StickOnAStick/48VRelay_essential/README.md

Ignore me trying to work with ki-cads git management. Project is located at `RelatBoard/48VRelay/48VERelay`
