StickOnAStick/48VRelay_essential/RelatBoard/48VRelay/48VERelay/_restore_backup_2026-08-07T21-41-39-209/report.txt

Update symbol C9 from 'Device:C_Small' to 'Device:C_Small': OK
