StickOnAStick/48VRelay_essential/RelatBoard/48VRelay/48VERelay/_restore_backup_2026-08-07T21-41-39-209/BOM/48VRelay_Approved_Vendor_List.xlsx

Sheet: Overview
48V Relay PCBA — Approved Vendor List
Generated | 2026-07-22
BOM lines | 51
Candidate rows | 204
Candidates per BOM line | 4
Primary selections | 51
Alternatives | 153
Use
This AVL is the controlled substitution list. The manufacturing BOM contains only one primary part per line. A substitute should only be used when its Approval Category is acceptable and its package, electrical limits, polarity, pinout, temperature range, and assembly method have been checked against the exact reference designators. Stock and pricing are order-time variables.
Approval category | Meaning
Primary Approved | Selected production primary for a READY line.
Approved Alternate | Intended as a drop-in alternate.
Conditional Alternate | Requires a stated electrical, mechanical, firmware, or sourcing check.
Redesign Only | Not a drop-in; layout or circuit changes are required.

Sheet: Approved Vendor List
BOM Line | Designator | BOM Value | Footprint | Candidate Rank | Role | Approval Category | Manufacturer | MPN | LCSC/JLCPCB Code | Package | Key Specifications | Availability | Price Indication | Compatibility | Qualification Notes | Source URL
1 | C1,C8,C26,C27 | 10uF | Capacitor_SMD:C_0805_2012Metric | 1 | Primary | Primary Approved | Samsung Electro-Mechanics | CL21A106KOQNNNE | C1713 | 0805 | 10 µF, 16 V, X5R, ±10% | Very high / JLC commodity |  | Drop-in |  | https://jlcpcb.com/partdetail/CL21A106KOQNNNE/C1713
1 | C1,C8,C26,C27 | 10uF | Capacitor_SMD:C_0805_2012Metric | 2 | Alternative 1 | Approved Alternate | Murata | GRM21BR61C106KE15L | C77075 | 0805 | 10 µF, 16 V, X5R, ±10% | High |  | Drop-in |  | https://jlcpcb.com/partdetail/MurataElectronics-GRM21BR61C106KE15L/C77075
1 | C1,C8,C26,C27 | 10uF | Capacitor_SMD:C_0805_2012Metric | 3 | Alternative 2 | Approved Alternate | TDK | C2012X5R1C106K125AC |  | 0805 | 10 µF, 16 V, X5R, ±10% | High / distributor commodity |  | Drop-in |  | https://www.digikey.com/en/products/result?keywords=C2012X5R1C106K125AC
1 | C1,C8,C26,C27 | 10uF | Capacitor_SMD:C_0805_2012Metric | 4 | Alternative 3 | Approved Alternate | Taiyo Yuden | EMK212BBJ106KG-T |  | 0805 | 10 µF, 16 V, X5R, ±10% | High / distributor commodity |  | Drop-in |  | https://www.digikey.com/en/products/result?keywords=EMK212BBJ106KG-T
2 | C2,C28,C29 | 10uF | Capacitor_SMD:C_0603_1608Metric | 1 | Primary | Primary - Verify | Murata | GRM188R61C106KAALD | C86275 | 0603 | 10 µF, 16 V, X5R, ±10% | High JLC stock; extended part |  | Drop-in |  | https://jlcpcb.com/partdetail/MurataElectronics-GRM188R61C106KAALD/C86275
2 | C2,C28,C29 | 10uF | Capacitor_SMD:C_0603_1608Metric | 2 | Alternative 1 | Approved Alternate | Samsung Electro-Mechanics | CL10A106KO8NQNC | C962136 | 0603 | 10 µF, 16 V, X5R, ±10% | JLC listed |  | Drop-in |  | https://www.lcsc.com/product-detail/C962136.html
2 | C2,C28,C29 | 10uF | Capacitor_SMD:C_0603_1608Metric | 3 | Alternative 2 | Conditional Alternate | Murata | GRM188R61C106MA73D | C86277 | 0603 | 10 µF, 16 V, X5R, ±20% | High JLC stock; lower cost |  | Drop-in | Tolerance is ±20%; approve only where ±20% is acceptable. | https://jlcpcb.com/partdetail/MurataElectronics-GRM188R61C106MA73D/C86277
2 | C2,C28,C29 | 10uF | Capacitor_SMD:C_0603_1608Metric | 4 | Alternative 3 | Conditional Alternate | TDK | C1608X5R1C106M080AB | C2167896 | 0603 | 10 µF, 16 V, X5R, ±20% | LCSC/JLC listed |  | Drop-in | Tolerance is ±20%; approve only where ±20% is acceptable. | https://www.lcsc.com/product-detail/C2167896.html
3 | C3,C4 | 0.1uF | Capacitor_SMD:C_0603_1608Metric | 1 | Primary | Primary Approved | Yageo | CC0603KRX7R9BB104 | C14663 | 0603 | 100 nF, 50 V, X7R, ±10% | Very high / JLC basic |  | Drop-in |  | https://jlcpcb.com/partdetail/CC0603KRX7R9BB104/C14663
3 | C3,C4 | 0.1uF | Capacitor_SMD:C_0603_1608Metric | 2 | Alternative 1 | Approved Alternate | Samsung Electro-Mechanics | CL10B104KB8NNNC |  | 0603 | 100 nF, 50 V, X7R, ±10% | High / commodity |  | Drop-in |  | https://www.digikey.com/en/products/result?keywords=CL10B104KB8NNNC
3 | C3,C4 | 0.1uF | Capacitor_SMD:C_0603_1608Metric | 3 | Alternative 2 | Approved Alternate | Murata | GRM188R71H104KA93D |  | 0603 | 100 nF, 50 V, X7R, ±10% | High / commodity |  | Drop-in |  | https://www.digikey.com/en/products/result?keywords=GRM188R71H104KA93D
3 | C3,C4 | 0.1uF | Capacitor_SMD:C_0603_1608Metric | 4 | Alternative 3 | Approved Alternate | TDK | C1608X7R1H104K080AA |  | 0603 | 100 nF, 50 V, X7R, ±10% | High / commodity |  | Drop-in |  | https://www.digikey.com/en/products/result?keywords=C1608X7R1H104K080AA
4 | C5 | 4.7uF - Eth Reference Cap | Capacitor_SMD:C_0201_0603Metric | 1 | Primary | Primary - Verify | Murata | GRM033R60J475ME05D |  | 0201 | 4.7 µF, 6.3 V, X5R, ±20% | Available, specialty/high-capacitance 0201 |  | Drop-in | Check effective capacitance under DC bias; 0201 assembly is less forgiving. | https://www.digikey.com/en/products/detail/murata-electronics/GRM033R60J475ME05D/16033659
4 | C5 | 4.7uF - Eth Reference Cap | Capacitor_SMD:C_0201_0603Metric | 2 | Alternative 1 | Approved Alternate | Samsung Electro-Mechanics | CL03A475MQ3CSNC |  | 0201 | 4.7 µF, 6.3 V, X5R, ±20% | Specialty |  | Drop-in |  | https://www.digikey.com/en/products/result?keywords=CL03A475MQ3CSNC
4 | C5 | 4.7uF - Eth Reference Cap | Capacitor_SMD:C_0201_0603Metric | 3 | Alternative 2 | Approved Alternate | TDK | C0603X5R0J475M030BC |  | 0201 | 4.7 µF, 6.3 V, X5R, ±20% | Specialty |  | Drop-in |  | https://www.digikey.com/en/products/result?keywords=C0603X5R0J475M030BC
4 | C5 | 4.7uF - Eth Reference Cap | Capacitor_SMD:C_0201_0603Metric | 4 | Alternative 3 | Approved Alternate | Taiyo Yuden | JMK063BJ475MP-F |  | 0201 | 4.7 µF, 6.3 V, X5R, ±20% | Specialty |  | Drop-in |  | https://www.digikey.com/en/products/result?keywords=JMK063BJ475MP-F
5 | C6 | 22nF | Capacitor_SMD:C_0201_0603Metric | 1 | Primary | Primary Approved | Murata | GRM033R71H223KA12D |  | 0201 | 22 nF, 50 V, X7R, ±10% | High / commodity |  | Drop-in |  | https://www.digikey.com/en/products/result?keywords=GRM033R71H223KA12D
5 | C6 | 22nF | Capacitor_SMD:C_0201_0603Metric | 2 | Alternative 1 | Approved Alternate | TDK | C0603X7R1H223K030BA |  | 0201 | 22 nF, 50 V, X7R, ±10% | High / commodity |  | Drop-in |  | https://www.digikey.com/en/products/result?keywords=C0603X7R1H223K030BA
5 | C6 | 22nF | Capacitor_SMD:C_0201_0603Metric | 3 | Alternative 2 | Approved Alternate | Samsung Electro-Mechanics | CL03B223KB3NNNC |  | 0201 | 22 nF, 50 V, X7R, ±10% | High / commodity |  | Drop-in |  | https://www.digikey.com/en/products/result?keywords=CL03B223KB3NNNC
5 | C6 | 22nF | Capacitor_SMD:C_0201_0603Metric | 4 | Alternative 3 | Approved Alternate | Yageo | CC0201KRX7R9BB223 |  | 0201 | 22 nF, 50 V, X7R, ±10% | High / commodity |  | Drop-in |  | https://www.digikey.com/en/products/result?keywords=CC0201KRX7R9BB223
6 | C7 | 0.1uF | Capacitor_SMD:C_0201_0603Metric | 1 | Primary | Primary Approved | Samsung Electro-Mechanics | CL03A104KA3NNNC | C307379 | 0201 | 100 nF, 25 V, X5R, ±10% | JLC stock; Standard PCBA only |  | Drop-in |  | https://jlcpcb.com/partdetail/291053-CL03A104KA3NNNC/C307379
6 | C7 | 0.1uF | Capacitor_SMD:C_0201_0603Metric | 2 | Alternative 1 | Approved Alternate | Murata | GRM033R71E104KE14D |  | 0201 | 100 nF, 25 V, X7R, ±10% | High / commodity |  | Drop-in |  | https://www.digikey.com/en/products/result?keywords=GRM033R71E104KE14D
6 | C7 | 0.1uF | Capacitor_SMD:C_0201_0603Metric | 3 | Alternative 2 | Approved Alternate | TDK | C0603X7R1E104K030BB |  | 0201 | 100 nF, 25 V, X7R, ±10% | High / commodity |  | Drop-in |  | https://www.digikey.com/en/products/result?keywords=C0603X7R1E104K030BB
6 | C7 | 0.1uF | Capacitor_SMD:C_0201_0603Metric | 4 | Alternative 3 | Approved Alternate | Yageo | CC0201KRX7R8BB104 |  | 0201 | 100 nF, 25 V, X7R, ±10% | High / commodity |  | Drop-in |  | https://www.digikey.com/en/products/result?keywords=CC0201KRX7R8BB104
7 | C9 | 100uF - Electrolytic | Capacitor_SMD:C_Elec_6.3x7.7 | 1 | Primary | Primary - Verify | Panasonic | EEE-FK1E101P |  | 6.3 x 7.7 mm SMD can | 100 µF, 25 V, low-ESR aluminum electrolytic | High |  | Mechanical match; verify land pattern |  | https://www.digikey.com/en/products/result?keywords=EEE-FK1E101P
7 | C9 | 100uF - Electrolytic | Capacitor_SMD:C_Elec_6.3x7.7 | 2 | Alternative 1 | Conditional Alternate | Nichicon | UWT1E101MCL1GS |  | 6.3 x 7.7 mm SMD can | 100 µF, 25 V aluminum electrolytic | High |  | Mechanical match; verify land pattern |  | https://www.digikey.com/en/products/result?keywords=UWT1E101MCL1GS
7 | C9 | 100uF - Electrolytic | Capacitor_SMD:C_Elec_6.3x7.7 | 3 | Alternative 2 | Conditional Alternate | United Chemi-Con | EMVE250ADA101MF80G |  | 6.3 x 7.7 mm SMD can | 100 µF, 25 V aluminum electrolytic | High |  | Mechanical match; verify land pattern |  | https://www.digikey.com/en/products/result?keywords=EMVE250ADA101MF80G
7 | C9 | 100uF - Electrolytic | Capacitor_SMD:C_Elec_6.3x7.7 | 4 | Alternative 3 | Conditional Alternate | Rubycon | 25SEV100M6.3X8 |  | 6.3 x 7.7/8 mm SMD can | 100 µF, 25 V aluminum electrolytic | Medium |  | Verify land pattern and height |  | https://www.digikey.com/en/products/result?keywords=25SEV100M6.3X8
8 | C10 | 100nF - Ceramic | Capacitor_SMD:C_0603_1608Metric | 1 | Primary | Primary Approved | Yageo | CC0603KRX7R9BB104 | C14663 | 0603 | 100 nF, 50 V, X7R, ±10% | Very high / JLC basic |  | Drop-in |  | https://jlcpcb.com/partdetail/CC0603KRX7R9BB104/C14663
8 | C10 | 100nF - Ceramic | Capacitor_SMD:C_0603_1608Metric | 2 | Alternative 1 | Approved Alternate | Murata | GRM188R71H104KA93D |  | 0603 | 100 nF, 50 V, X7R, ±10% | High / commodity |  | Drop-in |  | https://www.digikey.com/en/products/result?keywords=GRM188R71H104KA93D
8 | C10 | 100nF - Ceramic | Capacitor_SMD:C_0603_1608Metric | 3 | Alternative 2 | Approved Alternate | TDK | C1608X7R1H104K080AA |  | 0603 | 100 nF, 50 V, X7R, ±10% | High / commodity |  | Drop-in |  | https://www.digikey.com/en/products/result?keywords=C1608X7R1H104K080AA
8 | C10 | 100nF - Ceramic | Capacitor_SMD:C_0603_1608Metric | 4 | Alternative 3 | Approved Alternate | Samsung Electro-Mechanics | CL10B104KB8NNNC |  | 0603 | 100 nF, 50 V, X7R, ±10% | High / commodity |  | Drop-in |  | https://www.digikey.com/en/products/result?keywords=CL10B104KB8NNNC
9 | C11,C12,C13,C14,C15,C16 | 0.1uF | Capacitor_SMD:C_0402_1005Metric | 1 | Primary | Primary Approved | Samsung Electro-Mechanics | CL05B104KO5NNNC | C1525 | 0402 | 100 nF, 16 V, X7R, ±10% | Very high / JLC basic |  | Drop-in |  | https://jlcpcb.com/parts/basic_parts/
9 | C11,C12,C13,C14,C15,C16 | 0.1uF | Capacitor_SMD:C_0402_1005Metric | 2 | Alternative 1 | Approved Alternate | Murata | GRM155R71H104KE14D | C77020 | 0402 | 100 nF, 50 V, X7R, ±10% | JLC listed; extended |  | Drop-in |  | https://jlcpcb.com/partdetail/MurataElectronics-GRM155R71H104KE14D/C77020
9 | C11,C12,C13,C14,C15,C16 | 0.1uF | Capacitor_SMD:C_0402_1005Metric | 3 | Alternative 2 | Approved Alternate | Yageo | CC0402KRX7R9BB104 |  | 0402 | 100 nF, 50 V, X7R, ±10% | High / commodity |  | Drop-in |  | https://www.digikey.com/en/products/result?keywords=CC0402KRX7R9BB104
9 | C11,C12,C13,C14,C15,C16 | 0.1uF | Capacitor_SMD:C_0402_1005Metric | 4 | Alternative 3 | Approved Alternate | TDK | C1005X7R1H104K050BB |  | 0402 | 100 nF, 50 V, X7R, ±10% | High / commodity |  | Drop-in |  | https://www.digikey.com/en/products/result?keywords=C1005X7R1H104K050BB
10 | C17,C19 | 6.8nF | Capacitor_SMD:C_0201_0603Metric | 1 | Primary | Primary Approved | Murata | GRM033R71H682KA12D |  | 0201 | 6.8 nF, 50 V, X7R, ±10% | High / commodity |  | Drop-in |  | https://www.digikey.com/en/products/result?keywords=GRM033R71H682KA12D
10 | C17,C19 | 6.8nF | Capacitor_SMD:C_0201_0603Metric | 2 | Alternative 1 | Approved Alternate | TDK | C0603X7R1H682K030BA |  | 0201 | 6.8 nF, 50 V, X7R, ±10% | High / commodity |  | Drop-in |  | https://www.digikey.com/en/products/result?keywords=C0603X7R1H682K030BA
10 | C17,C19 | 6.8nF | Capacitor_SMD:C_0201_0603Metric | 3 | Alternative 2 | Approved Alternate | Samsung Electro-Mechanics | CL03B682KB3NNNC |  | 0201 | 6.8 nF, 50 V, X7R, ±10% | High / commodity |  | Drop-in |  | https://www.digikey.com/en/products/result?keywords=CL03B682KB3NNNC
10 | C17,C19 | 6.8nF | Capacitor_SMD:C_0201_0603Metric | 4 | Alternative 3 | Approved Alternate | Yageo | CC0201KRX7R9BB682 |  | 0201 | 6.8 nF, 50 V, X7R, ±10% | High / commodity |  | Drop-in |  | https://www.digikey.com/en/products/result?keywords=CC0201KRX7R9BB682
11 | C18 | 10uF / 16V | Capacitor_SMD:C_0805_2012Metric | 1 | Primary | Primary Approved | Samsung Electro-Mechanics | CL21A106KOQNNNE |  | 0805 | 10 µF, 16 V, X5R, ±10% | Medium; exact Samsung listing varies |  | Drop-in |  | https://www.digikey.com/en/products/detail/samsung-electro-mechanics/CL21A106KOQNNNE/3886754
11 | C18 | 10uF / 16V | Capacitor_SMD:C_0805_2012Metric | 2 | Alternative 1 | Approved Alternate | Murata | GRM21BR61C106KE15L |  | 0805 | 10 µF, 16 V, X5R, ±10% | High / commodity |  | Drop-in |  | https://www.digikey.com/en/products/result?keywords=GRM21BR61C106KE15L
11 | C18 | 10uF / 16V | Capacitor_SMD:C_0805_2012Metric | 3 | Alternative 2 | Approved Alternate | TDK | C2012X5R1C106K125AC |  | 0805 | 10 µF, 16 V, X5R, ±10% | High / commodity |  | Drop-in |  | https://www.digikey.com/en/products/result?keywords=C2012X5R1C106K125AC
11 | C18 | 10uF / 16V | Capacitor_SMD:C_0805_2012Metric | 4 | Alternative 3 | Approved Alternate | Taiyo Yuden | EMK212BBJ106KG-T |  | 0805 | 10 µF, 16 V, X5R, ±10% | High / commodity |  | Drop-in |  | https://www.digikey.com/en/products/result?keywords=EMK212BBJ106KG-T
12 | C20,C23 | 10nF | Capacitor_SMD:C_0201_0603Metric | 1 | Primary | Primary Approved | Murata | GRM033R71H103KA12D |  | 0201 | 10 nF, 50 V, X7R, ±10% | High / commodity |  | Drop-in |  | https://www.digikey.com/en/products/result?keywords=GRM033R71H103KA12D
12 | C20,C23 | 10nF | Capacitor_SMD:C_0201_0603Metric | 2 | Alternative 1 | Approved Alternate | TDK | C0603X7R1H103K030BB |  | 0201 | 10 nF, 50 V, X7R, ±10% | High / commodity |  | Drop-in |  | https://www.digikey.com/en/products/result?keywords=C0603X7R1H103K030BB
12 | C20,C23 | 10nF | Capacitor_SMD:C_0201_0603Metric | 3 | Alternative 2 | Approved Alternate | Samsung Electro-Mechanics | CL03B103KB3NNNC |  | 0201 | 10 nF, 50 V, X7R, ±10% | High / commodity |  | Drop-in |  | https://www.digikey.com/en/products/result?keywords=CL03B103KB3NNNC
12 | C20,C23 | 10nF | Capacitor_SMD:C_0201_0603Metric | 4 | Alternative 3 | Approved Alternate | Yageo | CC0201KRX7R9BB103 |  | 0201 | 10 nF, 50 V, X7R, ±10% | High / commodity |  | Drop-in |  | https://www.digikey.com/en/products/result?keywords=CC0201KRX7R9BB103
13 | C21,C22 | 18pF | Capacitor_SMD:C_0201_0603Metric | 1 | Primary | Primary Approved | Murata | GRM0335C1H180JA01D |  | 0201 | 18 pF, 50 V, C0G/NP0, ±5% | High / commodity |  | Drop-in |  | https://www.digikey.com/en/products/result?keywords=GRM0335C1H180JA01D
13 | C21,C22 | 18pF | Capacitor_SMD:C_0201_0603Metric | 2 | Alternative 1 | Approved Alternate | TDK | C0603C0G1H180J030BA |  | 0201 | 18 pF, 50 V, C0G/NP0, ±5% | High / commodity |  | Drop-in |  | https://www.digikey.com/en/products/result?keywords=C0603C0G1H180J030BA
13 | C21,C22 | 18pF | Capacitor_SMD:C_0201_0603Metric | 3 | Alternative 2 | Approved Alternate | Samsung Electro-Mechanics | CL03C180JB3NNNC |  | 0201 | 18 pF, 50 V, C0G/NP0, ±5% | High / commodity |  | Drop-in |  | https://www.digikey.com/en/products/result?keywords=CL03C180JB3NNNC
13 | C21,C22 | 18pF | Capacitor_SMD:C_0201_0603Metric | 4 | Alternative 3 | Approved Alternate | Yageo | CC0201JRNPO9BN180 |  | 0201 | 18 pF, 50 V, C0G/NP0, ±5% | High / commodity |  | Drop-in |  | https://www.digikey.com/en/products/result?keywords=CC0201JRNPO9BN180
14 | C24 | 1uF - Ceramic | Capacitor_SMD:C_0805_2012Metric | 1 | Primary | Primary Approved | Samsung Electro-Mechanics | CL21A105KAFNNNE | C95840 | 0805 | 1 µF, 25 V, X5R, ±10% | High / commodity |  | Drop-in |  | https://jlcpcb.com/partdetail/97044-CL21A105KAFNNNE/C95840
14 | C24 | 1uF - Ceramic | Capacitor_SMD:C_0805_2012Metric | 2 | Alternative 1 | Approved Alternate | Murata | GRM21BR71E105KA99L |  | 0805 | 1 µF, 25 V, X7R, ±10% | High / commodity |  | Drop-in |  | https://www.digikey.com/en/products/result?keywords=GRM21BR71E105KA99L
14 | C24 | 1uF - Ceramic | Capacitor_SMD:C_0805_2012Metric | 3 | Alternative 2 | Approved Alternate | TDK | C2012X7R1E105K125AB |  | 0805 | 1 µF, 25 V, X7R, ±10% | High / commodity |  | Drop-in |  | https://www.digikey.com/en/products/result?keywords=C2012X7R1E105K125AB
14 | C24 | 1uF - Ceramic | Capacitor_SMD:C_0805_2012Metric | 4 | Alternative 3 | Approved Alternate | Taiyo Yuden | TMK212B7105KG-T |  | 0805 | 1 µF, 25 V, X7R, ±10% | High / commodity |  | Drop-in |  | https://www.digikey.com/en/products/result?keywords=TMK212B7105KG-T
15 | C25 | 100nF | Capacitor_SMD:C_0201_0603Metric | 1 | Primary | Primary Approved | Samsung Electro-Mechanics | CL03A104KA3NNNC | C307379 | 0201 | 100 nF, 25 V, X5R, ±10% | JLC stock; Standard PCBA only |  | Drop-in |  | https://jlcpcb.com/partdetail/291053-CL03A104KA3NNNC/C307379
15 | C25 | 100nF | Capacitor_SMD:C_0201_0603Metric | 2 | Alternative 1 | Approved Alternate | Murata | GRM033R71E104KE14D |  | 0201 | 100 nF, 25 V, X7R, ±10% | High / commodity |  | Drop-in |  | https://www.digikey.com/en/products/result?keywords=GRM033R71E104KE14D
15 | C25 | 100nF | Capacitor_SMD:C_0201_0603Metric | 3 | Alternative 2 | Approved Alternate | TDK | C0603X7R1E104K030BB |  | 0201 | 100 nF, 25 V, X7R, ±10% | High / commodity |  | Drop-in |  | https://www.digikey.com/en/products/result?keywords=C0603X7R1E104K030BB
15 | C25 | 100nF | Capacitor_SMD:C_0201_0603Metric | 4 | Alternative 3 | Approved Alternate | Yageo | CC0201KRX7R8BB104 |  | 0201 | 100 nF, 25 V, X7R, ±10% | High / commodity |  | Drop-in |  | https://www.digikey.com/en/products/result?keywords=CC0201KRX7R8BB104
16 | C30,C31 | 22uF | Capacitor_SMD:C_0805_2012Metric | 1 | Primary | Primary - Verify | Murata | GRM21BR61A226ME44K |  | 0805 | 22 µF, 10 V, X5R, ±20% | High |  | Drop-in | Verify effective capacitance at the actual rail voltage. | https://www.digikey.com/en/products/detail/murata-electronics/GRM21BR61A226ME44K/26223516
16 | C30,C31 | 22uF | Capacitor_SMD:C_0805_2012Metric | 2 | Alternative 1 | Approved Alternate | TDK | C2012X5R1A226M125AC |  | 0805 | 22 µF, 10 V, X5R, ±20% | High / commodity |  | Drop-in |  | https://www.digikey.com/en/products/result?keywords=C2012X5R1A226M125AC
16 | C30,C31 | 22uF | Capacitor_SMD:C_0805_2012Metric | 3 | Alternative 2 | Approved Alternate | Taiyo Yuden | LMK212BBJ226MG-T |  | 0805 | 22 µF, 10 V, X5R, ±20% | High / commodity |  | Drop-in |  | https://www.digikey.com/en/products/result?keywords=LMK212BBJ226MG-T
16 | C30,C31 | 22uF | Capacitor_SMD:C_0805_2012Metric | 4 | Alternative 3 | Approved Alternate | Kyocera AVX | 0805ZD226MAT2A |  | 0805 | 22 µF, 10 V, X5R, ±20% | High / commodity |  | Drop-in |  | https://www.digikey.com/en/products/result?keywords=0805ZD226MAT2A
17 | C32,C33,C34,C35 | 1uF | Capacitor_SMD:C_0805_2012Metric | 1 | Primary | Primary Approved | Samsung Electro-Mechanics | CL21A105KAFNNNE | C95840 | 0805 | 1 µF, 25 V, X5R, ±10% | JLC listed / high |  | Drop-in |  | https://jlcpcb.com/partdetail/97044-CL21A105KAFNNNE/C95840
17 | C32,C33,C34,C35 | 1uF | Capacitor_SMD:C_0805_2012Metric | 2 | Alternative 1 | Approved Alternate | Samsung Electro-Mechanics | CL21B105KAFNNNE | C116352 | 0805 | 1 µF, 25 V, X7R, ±10% | JLC listed |  | Drop-in |  | https://jlcpcb.com/partdetail/117606-CL21B105KAFNNNE/C116352
17 | C32,C33,C34,C35 | 1uF | Capacitor_SMD:C_0805_2012Metric | 3 | Alternative 2 | Approved Alternate | Murata | GRM21BR71E105KA99L |  | 0805 | 1 µF, 25 V, X7R, ±10% | High / commodity |  | Drop-in |  | https://www.digikey.com/en/products/result?keywords=GRM21BR71E105KA99L
17 | C32,C33,C34,C35 | 1uF | Capacitor_SMD:C_0805_2012Metric | 4 | Alternative 3 | Approved Alternate | TDK | C2012X7R1E105K125AB |  | 0805 | 1 µF, 25 V, X7R, ±10% | High / commodity |  | Drop-in |  | https://www.digikey.com/en/products/result?keywords=C2012X7R1E105K125AB
18 | C36,C37 | 1uF | Capacitor_SMD:C_0402_1005Metric | 1 | Primary | Primary Approved | Samsung Electro-Mechanics | CL05A105KO5NNNC | C29266 | 0402 | 1 µF, 16 V, X5R, ±10% | JLC listed |  | Drop-in |  | https://jlcpcb.com/partdetail/C29266
18 | C36,C37 | 1uF | Capacitor_SMD:C_0402_1005Metric | 2 | Alternative 1 | Approved Alternate | Samsung Electro-Mechanics | CL05A105KA5NQNC | C52923 | 0402 | 1 µF, 25 V, X5R, ±10% | JLC listed |  | Drop-in |  | https://jlcpcb.com/partdetail/C52923
18 | C36,C37 | 1uF | Capacitor_SMD:C_0402_1005Metric | 3 | Alternative 2 | Conditional Alternate | Samsung Electro-Mechanics | CL05A105KP5NNNC | C14445 | 0402 | 1 µF, 10 V, X5R, ±10% | JLC listed / low cost |  | Drop-in | Use only on rails comfortably below 10 V. | https://jlcpcb.com/partdetail/CL05A105KP5NNNC/C14445
18 | C36,C37 | 1uF | Capacitor_SMD:C_0402_1005Metric | 4 | Alternative 3 | Conditional Alternate | Murata | GRM155R61A105KE15D |  | 0402 | 1 µF, 10 V, X5R, ±10% | High / commodity |  | Drop-in | Use only on rails comfortably below 10 V. | https://www.digikey.com/en/products/result?keywords=GRM155R61A105KE15D
19 | D1,D2,D3,D4,D5 | LED VO-PT2012SEAC | LED_SMD:LED_0201_0603Metric | 1 | Primary | Proposed / Not Released | Lite-On | LTST-FC03AD-5A | C20617265 | LED 0201 | Amber/yellow indicator LED; verify Vf and polarity | JLC listing; check order-time stock |  | Drop-in |  | https://jlcpcb.com/partdetail/LiteOn-LTST_FC03AD5A/C20617265
19 | D1,D2,D3,D4,D5 | LED VO-PT2012SEAC | LED_SMD:LED_0201_0603Metric | 2 | Alternative 1 | Approved Alternate | Lite-On | LTST-FC03ED-5A | C20617267 | LED 0201 | Red indicator LED; verify desired color | JLC listing; check order-time stock |  | Drop-in |  | https://jlcpcb.com/partdetail/LiteOn-LTST_FC03ED5A/C20617267
19 | D1,D2,D3,D4,D5 | LED VO-PT2012SEAC | LED_SMD:LED_0201_0603Metric | 3 | Alternative 2 | Approved Alternate | Lite-On | LTST-FC03BD-5A | C20617266 | LED 0201 | Blue indicator LED; verify desired color | JLC listing; check order-time stock |  | Drop-in |  | https://jlcpcb.com/partdetail/LiteOn-LTST_FC03BD5A/C20617266
19 | D1,D2,D3,D4,D5 | LED VO-PT2012SEAC | LED_SMD:LED_0201_0603Metric | 4 | Alternative 3 | Approved Alternate | Everlight | CSP0603AN101-IBP20200453001-3T |  | LED 0201 | Indicator LED; verify color/bin and polarity | JLC searchable; check order-time stock |  | Drop-in |  | https://jlcpcb.com/parts/componentSearch?searchTxt=CSP0603AN101-IBP20200453001-3T
20 | D6 | LED | LED_SMD:LED_0201_0603Metric | 1 | Primary | Primary - Verify | Lite-On | LTST-FC03ED-5A | C20617267 | LED 0201 | Red indicator LED; verify desired color | JLC listing; check order-time stock |  | Drop-in |  | https://jlcpcb.com/partdetail/LiteOn-LTST_FC03ED5A/C20617267
20 | D6 | LED | LED_SMD:LED_0201_0603Metric | 2 | Alternative 1 | Approved Alternate | Lite-On | LTST-FC03AD-5A | C20617265 | LED 0201 | Amber/yellow indicator LED; verify Vf and polarity | JLC listing; check order-time stock |  | Drop-in |  | https://jlcpcb.com/partdetail/LiteOn-LTST_FC03AD5A/C20617265
20 | D6 | LED | LED_SMD:LED_0201_0603Metric | 3 | Alternative 2 | Approved Alternate | Lite-On | LTST-FC03BD-5A | C20617266 | LED 0201 | Blue indicator LED; verify desired color | JLC listing; check order-time stock |  | Drop-in |  | https://jlcpcb.com/partdetail/LiteOn-LTST_FC03BD5A/C20617266
20 | D6 | LED | LED_SMD:LED_0201_0603Metric | 4 | Alternative 3 | Approved Alternate | Everlight | CSP0603AN101-IBP20200453001-3T |  | LED 0201 | Indicator LED; verify color/bin and polarity | JLC searchable; check order-time stock |  | Drop-in |  | https://jlcpcb.com/parts/componentSearch?searchTxt=CSP0603AN101-IBP20200453001-3T
21 | F1,F2,F5 | 0685T5000 | Fuse:Fuse_0805_2012Metric | 1 | Primary | Proposed / Not Released | Bel Fuse | 0685T5000-01 |  | 1206 | 5 A, 63 V AC/DC, time-delay fuse | Very high distributor stock; JLC order-time check | ~$0.45-$0.80 | Layout change: current BOM footprint is 0805 |  | https://www.digikey.com/en/products/detail/bel-fuse-inc/0685T5000-01/4967966
21 | F1,F2,F5 | 0685T5000 | Fuse:Fuse_0805_2012Metric | 2 | Alternative 1 | Redesign Only | Bourns | SF-1206S500-2 |  | 1206 | 5 A slow-blow chip fuse; verify voltage/time-current | High |  | Layout change: 1206 |  | https://www.digikey.com/en/products/result?keywords=SF-1206S500-2
21 | F1,F2,F5 | 0685T5000 | Fuse:Fuse_0805_2012Metric | 3 | Alternative 2 | Redesign Only | Eaton | CC12H5A-TR |  | 1206 | 5 A chip fuse; verify time-delay curve | High |  | Layout change: 1206 |  | https://www.digikey.com/en/products/result?keywords=CC12H5A-TR
21 | F1,F2,F5 | 0685T5000 | Fuse:Fuse_0805_2012Metric | 4 | Alternative 3 | Redesign Only | Littelfuse | 0467005.NRHF |  | 1206 | 5 A chip fuse; verify speed and DC interrupt rating | High |  | Layout change: 1206 |  | https://www.digikey.com/en/products/result?keywords=0467005.NRHF
22 | F3,F4 | 0685T5000-01 | Fuse:Fuse_0805_2012Metric | 1 | Primary | Proposed / Not Released | Bel Fuse | 0685T5000-01 |  | 1206 | 5 A, 63 V AC/DC, time-delay fuse | Very high distributor stock; JLC order-time check | ~$0.45-$0.80 | Layout change: current BOM footprint is 0805 |  | https://www.digikey.com/en/products/detail/bel-fuse-inc/0685T5000-01/4967966
22 | F3,F4 | 0685T5000-01 | Fuse:Fuse_0805_2012Metric | 2 | Alternative 1 | Redesign Only | Bourns | SF-1206S500-2 |  | 1206 | 5 A slow-blow chip fuse; verify voltage/time-current | High |  | Layout change: 1206 |  | https://www.digikey.com/en/products/result?keywords=SF-1206S500-2
22 | F3,F4 | 0685T5000-01 | Fuse:Fuse_0805_2012Metric | 3 | Alternative 2 | Redesign Only | Eaton | CC12H5A-TR |  | 1206 | 5 A chip fuse; verify time-delay curve | High |  | Layout change: 1206 |  | https://www.digikey.com/en/products/result?keywords=CC12H5A-TR
22 | F3,F4 | 0685T5000-01 | Fuse:Fuse_0805_2012Metric | 4 | Alternative 3 | Redesign Only | Littelfuse | 0467005.NRHF |  | 1206 | 5 A chip fuse; verify speed and DC interrupt rating | High |  | Layout change: 1206 |  | https://www.digikey.com/en/products/result?keywords=0467005.NRHF
23 | J1 | 12 | Connector_BarrelJack:BarrelJack_CUI_PJ-102AH_Horizontal | 1 | Primary | Primary - Verify | Same Sky / CUI Devices | PJ-102AH | C9900001188 | THT horizontal barrel jack | 2.0 mm center pin, switched contact; verify adapter plug/current | Available at distributors; JLC extended/preorder |  | Drop-in |  | https://jlcpcb.com/partdetail/CUIDevices-PJ102AH/C9900001188
23 | J1 | 12 | Connector_BarrelJack:BarrelJack_CUI_PJ-102AH_Horizontal | 2 | Alternative 1 | Conditional Alternate | GCT | DCJ200-10-A-K1-K |  | THT horizontal barrel jack | 2.0 mm center pin; verify pinout/current | High |  | Mechanical/pinout verification |  | https://www.digikey.com/en/products/result?keywords=DCJ200-10-A-K1-K
23 | J1 | 12 | Connector_BarrelJack:BarrelJack_CUI_PJ-102AH_Horizontal | 3 | Alternative 2 | Conditional Alternate | Kycon | KLDX-0202-A |  | THT horizontal barrel jack | 2.0 mm center pin; verify pinout/current | High |  | Layout likely changes |  | https://www.digikey.com/en/products/result?keywords=KLDX-0202-A
23 | J1 | 12 | Connector_BarrelJack:BarrelJack_CUI_PJ-102AH_Horizontal | 4 | Alternative 3 | Conditional Alternate | Same Sky / CUI Devices | PJ-102A |  | THT horizontal barrel jack | 2.0 mm center pin; verify switch/pinout | High |  | Layout/pinout verification |  | https://www.digikey.com/en/products/result?keywords=PJ-102A
24 | J2 | RJ45_Hanrun_HR911105A_Horizontal | Connector_RJ:RJ45_Hanrun_HR911105A_Horizontal | 1 | Primary | Primary Approved | HanRun | HR911105A | C12074 | THT MagJack | 10/100BASE-T, integrated magnetics and LEDs | JLC stock reported high | ~$1.49 | Drop-in |  | https://jlcpcb.com/partdetail/HanRun-HR911105A/C12074
24 | J2 | RJ45_Hanrun_HR911105A_Horizontal | Connector_RJ:RJ45_Hanrun_HR911105A_Horizontal | 2 | Alternative 1 | Conditional Alternate | UDE | RB1-125BAG1A |  | THT MagJack | 10/100BASE-T integrated magnetics/LEDs | High |  | Mechanical/pinout verification |  | https://www.digikey.com/en/products/result?keywords=RB1-125BAG1A
24 | J2 | RJ45_Hanrun_HR911105A_Horizontal | Connector_RJ:RJ45_Hanrun_HR911105A_Horizontal | 3 | Alternative 2 | Conditional Alternate | Pulse Electronics | J0011D21BNL |  | THT MagJack | 10/100BASE-T integrated magnetics/LEDs | High |  | Layout/pinout change likely |  | https://www.digikey.com/en/products/result?keywords=J0011D21BNL
24 | J2 | RJ45_Hanrun_HR911105A_Horizontal | Connector_RJ:RJ45_Hanrun_HR911105A_Horizontal | 4 | Alternative 3 | Conditional Alternate | Würth Elektronik | 7499111121A |  | THT MagJack | 10/100BASE-T integrated magnetics/LEDs | High |  | Layout/pinout change likely |  | https://www.digikey.com/en/products/result?keywords=7499111121A
25 | J3 | B4B-PH-SM4-TB | Connector_PinHeader_2.54mm:PinHeader_1x04_P2.54mm_Vertical | 1 | Primary | Proposed / Not Released | BOOMELE / generic | 2.54-1*4P | C49257 | 1x4, 2.54 mm, vertical THT | Standard male pin header | Very high / JLC commodity | <$0.05 typical | Matches current KiCad footprint; not JST-PH |  | https://www.lcsc.com/search?q=C49257
25 | J3 | B4B-PH-SM4-TB | Connector_PinHeader_2.54mm:PinHeader_1x04_P2.54mm_Vertical | 2 | Alternative 1 | Approved Alternate | Harwin | M20-9990445 |  | 1x4, 2.54 mm, vertical THT | Gold/tin pin header | High |  | Drop-in mechanical |  | https://www.digikey.com/en/products/result?keywords=M20-9990445
25 | J3 | B4B-PH-SM4-TB | Connector_PinHeader_2.54mm:PinHeader_1x04_P2.54mm_Vertical | 3 | Alternative 2 | Approved Alternate | Würth Elektronik | 61300411121 |  | 1x4, 2.54 mm, vertical THT | Standard pin header | High |  | Drop-in mechanical |  | https://www.digikey.com/en/products/result?keywords=61300411121
25 | J3 | B4B-PH-SM4-TB | Connector_PinHeader_2.54mm:PinHeader_1x04_P2.54mm_Vertical | 4 | Alternative 3 | Conditional Alternate | Samtec | TSW-104-07-G-S |  | 1x4, 2.54 mm, vertical THT | Premium pin header | High |  | Drop-in mechanical; verify pin length |  | https://www.digikey.com/en/products/result?keywords=TSW-104-07-G-S
26 | J10,J11,J12,J13,J14 | Screw_Terminal_01x03 | TerminalBlock:TerminalBlock_MaiXu_MX126-5.0-03P_1x03_P5.00mm | 1 | Primary | Primary - Verify | MAX / MaiXu | MX126-5.0-03P-GN01-Cu-S-A | C5188435 | 3-pos THT, 5.00 mm | 10 A, 300 V, 14-26 AWG | JLC listed | ~$0.10-$0.25 | Drop-in if exact custom footprint |  | https://jlcpcb.com/partdetail/MAX-MX126_5_003P_GN01_Cu_S_A/C5188435
26 | J10,J11,J12,J13,J14 | Screw_Terminal_01x03 | TerminalBlock:TerminalBlock_MaiXu_MX126-5.0-03P_1x03_P5.00mm | 2 | Alternative 1 | Conditional Alternate | Degson | DG126-5.0-03P-1400AH |  | 3-pos THT, 5.00 mm | Terminal block, 5.0 mm pitch | High |  | Verify body/pin dimensions |  | https://www.digikey.com/en/products/result?keywords=DG126-5.0-03P-1400AH
26 | J10,J11,J12,J13,J14 | Screw_Terminal_01x03 | TerminalBlock:TerminalBlock_MaiXu_MX126-5.0-03P_1x03_P5.00mm | 3 | Alternative 2 | Conditional Alternate | On Shore Technology | OSTTA034163 |  | 3-pos THT, 5.00 mm | Terminal block, 5.0 mm pitch | High |  | Verify body/pin dimensions |  | https://www.digikey.com/en/products/result?keywords=OSTTA034163
26 | J10,J11,J12,J13,J14 | Screw_Terminal_01x03 | TerminalBlock:TerminalBlock_MaiXu_MX126-5.0-03P_1x03_P5.00mm | 4 | Alternative 3 | Redesign Only | Phoenix Contact | 1935161 |  | 3-pos THT, 5.08 mm | MKDS series terminal block | High |  | Pitch/layout change: 5.08 mm |  | https://www.digikey.com/en/products/result?keywords=1935161
27 | K10,K11,K12,K13,K14 | G2RL-1-E | Relay_THT:Relay_SPDT_Omron_G2RL-1-E | 1 | Primary | Primary - Verify | Omron | G2RL-1-E-DC12 | C58243 | THT SPDT | 12 V coil; 16 A at 24 VDC resistive; 300 VDC max switching voltage | JLC stock reported high | ~$1.57 | Drop-in | 48-52 VDC at 2 A is not the published rated-load point; qualify against the DC load curve, load type, life, and certification. | https://jlcpcb.com/partdetail/Omron-G2RL_1_E_DC12/C58243
27 | K10,K11,K12,K13,K14 | G2RL-1-E | Relay_THT:Relay_SPDT_Omron_G2RL-1-E | 2 | Alternative 1 | Conditional Alternate | Omron | G2RL-1-E-ASI-DC12 |  | THT SPDT | 12 V coil, high-capacity G2RL variant | High |  | Likely footprint-compatible; verify exact suffix |  | https://www.digikey.com/en/products/result?keywords=G2RL-1-E-ASI-DC12
27 | K10,K11,K12,K13,K14 | G2RL-1-E | Relay_THT:Relay_SPDT_Omron_G2RL-1-E | 3 | Alternative 2 | Conditional Alternate | TE Connectivity / Schrack | RT314012 |  | THT SPDT | 12 V coil power relay | High |  | Layout/pinout change likely; verify DC load rating |  | https://www.digikey.com/en/products/result?keywords=RT314012
27 | K10,K11,K12,K13,K14 | G2RL-1-E | Relay_THT:Relay_SPDT_Omron_G2RL-1-E | 4 | Alternative 3 | Conditional Alternate | Hongfa | HF115F/012-1ZS3 |  | THT SPDT | 12 V coil power relay | High |  | Layout/pinout change likely; verify DC load rating |  | https://www.digikey.com/en/products/result?keywords=HF115F%2F012-1ZS3
28 | L1 | MH1608-121Y | Library:IND_BOURNS_MH1608 | 1 | Primary | Primary Approved | Bourns | MH1608-121Y | C2650949 | 0603 | 120 Ω @ 100 MHz, 2 A, ≤100 mΩ | LCSC stock reported moderate | ~$0.06 | Drop-in |  | https://www.lcsc.com/product-detail/Ferrite-Beads_Bourns-MH1608-121Y_C2650949.html
28 | L1 | MH1608-121Y | Library:IND_BOURNS_MH1608 | 2 | Alternative 1 | Approved Alternate | TDK | MPZ1608S121ATA00 |  | 0603 | 120 Ω @ 100 MHz, 2 A class | Very high |  | Drop-in |  | https://www.digikey.com/en/products/result?keywords=MPZ1608S121ATA00
28 | L1 | MH1608-121Y | Library:IND_BOURNS_MH1608 | 3 | Alternative 2 | Approved Alternate | Murata | BLM18AG121SN1D |  | 0603 | 120 Ω @ 100 MHz, 2 A class | Very high |  | Drop-in |  | https://www.digikey.com/en/products/result?keywords=BLM18AG121SN1D
28 | L1 | MH1608-121Y | Library:IND_BOURNS_MH1608 | 4 | Alternative 3 | Approved Alternate | Taiyo Yuden | BK1608HS121-T |  | 0603 | 120 Ω @ 100 MHz; verify current/DCR | High |  | Drop-in |  | https://www.digikey.com/en/products/result?keywords=BK1608HS121-T
29 | L3 | XFL4020-152MEC | Library:IND_XFL4020_COC-M | 1 | Primary | Primary Approved | Coilcraft | XGL4020-152MEC |  | 4.0 x 4.0 mm | 1.5 µH, lower DCR, high-current; official drop-in successor to XFL4020 | High distributor availability |  | Drop-in / preferred upgrade |  | https://www.coilcraft.com/en-us/products/power/shielded-inductors/molded-inductor/xgl/xgl4020/
29 | L3 | XFL4020-152MEC | Library:IND_XFL4020_COC-M | 2 | Alternative 1 | Approved Alternate | Coilcraft | XFL4020-152MEC | C3033018 | 4.0 x 4.0 mm | 1.5 µH, ~4.6 A saturation class, low DCR | JLC listed |  | Drop-in |  | https://jlcpcb.com/partdetail/Coilcraft-XFL4020_152MEC/C3033018
29 | L3 | XFL4020-152MEC | Library:IND_XFL4020_COC-M | 3 | Alternative 2 | Conditional Alternate | Coilcraft | XEL4020-152MEC |  | 4.0 x 4.0 mm | 1.5 µH, high saturation current | High |  | Footprint-compatible family; verify height/loss |  | https://www.digikey.com/en/products/result?keywords=XEL4020-152MEC
29 | L3 | XFL4020-152MEC | Library:IND_XFL4020_COC-M | 4 | Alternative 3 | Conditional Alternate | Bourns | SRP4020TA-1R5M |  | 4.0 x 4.0 mm class | 1.5 µH shielded power inductor | High |  | Verify pad pattern, DCR, Isat and Irms |  | https://www.digikey.com/en/products/result?keywords=SRP4020TA-1R5M
30 | R1,R2,R3,R4,R5 | 2.2k | Resistor_SMD:R_0603_1608Metric | 1 | Primary | Primary Approved | UniOhm/Uniohm | 0603WAF2201T5E |  | 0603 | 2.2 kΩ, 1%, ≥0.1 W | Very high / commodity | <$0.01 typical | Drop-in |  | https://www.lcsc.com/search?q=0603WAF2201T5E
30 | R1,R2,R3,R4,R5 | 2.2k | Resistor_SMD:R_0603_1608Metric | 2 | Alternative 1 | Approved Alternate | Yageo | RC0603FR-072K2L |  | 0603 | 2.2 kΩ, 1%, ≥0.1 W | High / commodity |  | Drop-in |  | https://www.digikey.com/en/products/result?keywords=RC0603FR-072K2L
30 | R1,R2,R3,R4,R5 | 2.2k | Resistor_SMD:R_0603_1608Metric | 3 | Alternative 2 | Approved Alternate | Panasonic | ERJ-3EKF2201V |  | 0603 | 2.2 kΩ, 1%, ≥0.1 W | High / commodity |  | Drop-in |  | https://www.digikey.com/en/products/result?keywords=ERJ-3EKF2201V
30 | R1,R2,R3,R4,R5 | 2.2k | Resistor_SMD:R_0603_1608Metric | 4 | Alternative 3 | Approved Alternate | Vishay | CRCW06032K20FKEA |  | 0603 | 2.2 kΩ, 1%, ≥0.1 W | High / commodity |  | Drop-in |  | https://www.digikey.com/en/products/result?keywords=CRCW06032K20FKEA
31 | R6 | 12.4k 1% - Ethernet external reference | Resistor_SMD:R_0402_1005Metric | 1 | Primary | Primary Approved | UniOhm/Uniohm | 0402WGF1242TCE |  | 0402 | 12.4 kΩ, 1%, ≥0.063 W | Very high / commodity | <$0.01 typical | Drop-in |  | https://www.lcsc.com/search?q=0402WGF1242TCE
31 | R6 | 12.4k 1% - Ethernet external reference | Resistor_SMD:R_0402_1005Metric | 2 | Alternative 1 | Approved Alternate | Yageo | RC0402FR-0712K4L |  | 0402 | 12.4 kΩ, 1%, ≥0.063 W | High / commodity |  | Drop-in |  | https://www.digikey.com/en/products/result?keywords=RC0402FR-0712K4L
31 | R6 | 12.4k 1% - Ethernet external reference | Resistor_SMD:R_0402_1005Metric | 3 | Alternative 2 | Approved Alternate | Panasonic | ERJ-2RKF1242X |  | 0402 | 12.4 kΩ, 1%, ≥0.063 W | High / commodity |  | Drop-in |  | https://www.digikey.com/en/products/result?keywords=ERJ-2RKF1242X
31 | R6 | 12.4k 1% - Ethernet external reference | Resistor_SMD:R_0402_1005Metric | 4 | Alternative 3 | Approved Alternate | Vishay | CRCW040212K4FKED |  | 0402 | 12.4 kΩ, 1%, ≥0.063 W | High / commodity |  | Drop-in |  | https://www.digikey.com/en/products/result?keywords=CRCW040212K4FKED
32 | R7,R8,R16,R17 | 33 | Resistor_SMD:R_0603_1608Metric | 1 | Primary | Primary Approved | UniOhm/Uniohm | 0603WAF330JT5E |  | 0603 | 33 Ω, 1%, ≥0.1 W | Very high / commodity | <$0.01 typical | Drop-in |  | https://www.lcsc.com/search?q=0603WAF330JT5E
32 | R7,R8,R16,R17 | 33 | Resistor_SMD:R_0603_1608Metric | 2 | Alternative 1 | Approved Alternate | Yageo | RC0603FR-0733RL |  | 0603 | 33 Ω, 1%, ≥0.1 W | High / commodity |  | Drop-in |  | https://www.digikey.com/en/products/result?keywords=RC0603FR-0733RL
32 | R7,R8,R16,R17 | 33 | Resistor_SMD:R_0603_1608Metric | 3 | Alternative 2 | Approved Alternate | Panasonic | ERJ-3EKF33R0V |  | 0603 | 33 Ω, 1%, ≥0.1 W | High / commodity |  | Drop-in |  | https://www.digikey.com/en/products/result?keywords=ERJ-3EKF33R0V
32 | R7,R8,R16,R17 | 33 | Resistor_SMD:R_0603_1608Metric | 4 | Alternative 3 | Approved Alternate | Vishay | CRCW060333R0FKEA |  | 0603 | 33 Ω, 1%, ≥0.1 W | High / commodity |  | Drop-in |  | https://www.digikey.com/en/products/result?keywords=CRCW060333R0FKEA
33 | R9,R15,R29 | 330 | Resistor_SMD:R_0603_1608Metric | 1 | Primary | Primary Approved | UniOhm/Uniohm | 0603WAF3300T5E |  | 0603 | 330 Ω, 1%, ≥0.1 W | Very high / commodity | <$0.01 typical | Drop-in |  | https://www.lcsc.com/search?q=0603WAF3300T5E
33 | R9,R15,R29 | 330 | Resistor_SMD:R_0603_1608Metric | 2 | Alternative 1 | Approved Alternate | Yageo | RC0603FR-07330RL |  | 0603 | 330 Ω, 1%, ≥0.1 W | High / commodity |  | Drop-in |  | https://www.digikey.com/en/products/result?keywords=RC0603FR-07330RL
33 | R9,R15,R29 | 330 | Resistor_SMD:R_0603_1608Metric | 3 | Alternative 2 | Approved Alternate | Panasonic | ERJ-3EKF3300V |  | 0603 | 330 Ω, 1%, ≥0.1 W | High / commodity |  | Drop-in |  | https://www.digikey.com/en/products/result?keywords=ERJ-3EKF3300V
33 | R9,R15,R29 | 330 | Resistor_SMD:R_0603_1608Metric | 4 | Alternative 3 | Approved Alternate | Vishay | CRCW0603330RFKEA |  | 0603 | 330 Ω, 1%, ≥0.1 W | High / commodity |  | Drop-in |  | https://www.digikey.com/en/products/result?keywords=CRCW0603330RFKEA
34 | R10,R11,R12,R13,R14 | 100k | Resistor_SMD:R_0603_1608Metric | 1 | Primary | Primary Approved | UniOhm/Uniohm | 0603WAF1003T5E |  | 0603 | 100 kΩ, 1%, ≥0.1 W | Very high / commodity | <$0.01 typical | Drop-in |  | https://www.lcsc.com/search?q=0603WAF1003T5E
34 | R10,R11,R12,R13,R14 | 100k | Resistor_SMD:R_0603_1608Metric | 2 | Alternative 1 | Approved Alternate | Yageo | RC0603FR-07100KL |  | 0603 | 100 kΩ, 1%, ≥0.1 W | High / commodity |  | Drop-in |  | https://www.digikey.com/en/products/result?keywords=RC0603FR-07100KL
34 | R10,R11,R12,R13,R14 | 100k | Resistor_SMD:R_0603_1608Metric | 3 | Alternative 2 | Approved Alternate | Panasonic | ERJ-3EKF1003V |  | 0603 | 100 kΩ, 1%, ≥0.1 W | High / commodity |  | Drop-in |  | https://www.digikey.com/en/products/result?keywords=ERJ-3EKF1003V
34 | R10,R11,R12,R13,R14 | 100k | Resistor_SMD:R_0603_1608Metric | 4 | Alternative 3 | Approved Alternate | Vishay | CRCW0603100KFKEA |  | 0603 | 100 kΩ, 1%, ≥0.1 W | High / commodity |  | Drop-in |  | https://www.digikey.com/en/products/result?keywords=CRCW0603100KFKEA
35 | R18,R19,R21,R22 | 49.9 1% | Resistor_SMD:R_0201_0603Metric | 1 | Primary | Primary Approved | UniOhm/Uniohm | 0201WMF499JTCE |  | 0201 | 49.9 Ω, 1%, ≥0.05 W | Very high / commodity | <$0.01 typical | Drop-in |  | https://www.lcsc.com/search?q=0201WMF499JTCE
35 | R18,R19,R21,R22 | 49.9 1% | Resistor_SMD:R_0201_0603Metric | 2 | Alternative 1 | Approved Alternate | Yageo | RC0201FR-0749R9L |  | 0201 | 49.9 Ω, 1%, ≥0.05 W | High / commodity |  | Drop-in |  | https://www.digikey.com/en/products/result?keywords=RC0201FR-0749R9L
35 | R18,R19,R21,R22 | 49.9 1% | Resistor_SMD:R_0201_0603Metric | 3 | Alternative 2 | Approved Alternate | Panasonic | ERJ-1GNF49R9C |  | 0201 | 49.9 Ω, 1%, ≥0.05 W | High / commodity |  | Drop-in |  | https://www.digikey.com/en/products/result?keywords=ERJ-1GNF49R9C
35 | R18,R19,R21,R22 | 49.9 1% | Resistor_SMD:R_0201_0603Metric | 4 | Alternative 3 | Approved Alternate | Vishay | CRCW020149R9FKED |  | 0201 | 49.9 Ω, 1%, ≥0.05 W | High / commodity |  | Drop-in |  | https://www.digikey.com/en/products/result?keywords=CRCW020149R9FKED
36 | R20 | 10 1% | Resistor_SMD:R_0201_0603Metric | 1 | Primary | Primary Approved | UniOhm/Uniohm | 0201WMF100JTCE |  | 0201 | 10 Ω, 1%, ≥0.05 W | Very high / commodity | <$0.01 typical | Drop-in |  | https://www.lcsc.com/search?q=0201WMF100JTCE
36 | R20 | 10 1% | Resistor_SMD:R_0201_0603Metric | 2 | Alternative 1 | Approved Alternate | Yageo | RC0201FR-0710RL |  | 0201 | 10 Ω, 1%, ≥0.05 W | High / commodity |  | Drop-in |  | https://www.digikey.com/en/products/result?keywords=RC0201FR-0710RL
36 | R20 | 10 1% | Resistor_SMD:R_0201_0603Metric | 3 | Alternative 2 | Approved Alternate | Panasonic | ERJ-1GNF10R0C |  | 0201 | 10 Ω, 1%, ≥0.05 W | High / commodity |  | Drop-in |  | https://www.digikey.com/en/products/result?keywords=ERJ-1GNF10R0C
36 | R20 | 10 1% | Resistor_SMD:R_0201_0603Metric | 4 | Alternative 3 | Approved Alternate | Vishay | CRCW020110R0FKED |  | 0201 | 10 Ω, 1%, ≥0.05 W | High / commodity |  | Drop-in |  | https://www.digikey.com/en/products/result?keywords=CRCW020110R0FKED
37 | R23 | 0 | Resistor_SMD:R_0402_1005Metric | 1 | Primary | Primary Approved | UniOhm/Uniohm | 0402WGJ0000TCE |  | 0402 | 0 Ω jumper, ≥0.063 W | Very high / commodity | <$0.01 typical | Drop-in |  | https://www.lcsc.com/search?q=0402WGJ0000TCE
37 | R23 | 0 | Resistor_SMD:R_0402_1005Metric | 2 | Alternative 1 | Approved Alternate | Yageo | RC0402JR-070RL |  | 0402 | 0 Ω jumper, ≥0.063 W | High / commodity |  | Drop-in |  | https://www.digikey.com/en/products/result?keywords=RC0402JR-070RL
37 | R23 | 0 | Resistor_SMD:R_0402_1005Metric | 3 | Alternative 2 | Approved Alternate | Panasonic | ERJ-2GE0R00X |  | 0402 | 0 Ω jumper, ≥0.063 W | High / commodity |  | Drop-in |  | https://www.digikey.com/en/products/result?keywords=ERJ-2GE0R00X
37 | R23 | 0 | Resistor_SMD:R_0402_1005Metric | 4 | Alternative 3 | Approved Alternate | Vishay | CRCW04020000Z0ED |  | 0402 | 0 Ω jumper, ≥0.063 W | High / commodity |  | Drop-in |  | https://www.digikey.com/en/products/result?keywords=CRCW04020000Z0ED
38 | R24 | 1M | Resistor_SMD:R_0402_1005Metric | 1 | Primary | Primary Approved | UniOhm/Uniohm | 0402WGF1004TCE |  | 0402 | 1 MΩ, 1%, ≥0.063 W | Very high / commodity | <$0.01 typical | Drop-in |  | https://www.lcsc.com/search?q=0402WGF1004TCE
38 | R24 | 1M | Resistor_SMD:R_0402_1005Metric | 2 | Alternative 1 | Approved Alternate | Yageo | RC0402FR-071ML |  | 0402 | 1 MΩ, 1%, ≥0.063 W | High / commodity |  | Drop-in |  | https://www.digikey.com/en/products/result?keywords=RC0402FR-071ML
38 | R24 | 1M | Resistor_SMD:R_0402_1005Metric | 3 | Alternative 2 | Approved Alternate | Panasonic | ERJ-2RKF1004X |  | 0402 | 1 MΩ, 1%, ≥0.063 W | High / commodity |  | Drop-in |  | https://www.digikey.com/en/products/result?keywords=ERJ-2RKF1004X
38 | R24 | 1M | Resistor_SMD:R_0402_1005Metric | 4 | Alternative 3 | Approved Alternate | Vishay | CRCW04021M00FKED |  | 0402 | 1 MΩ, 1%, ≥0.063 W | High / commodity |  | Drop-in |  | https://www.digikey.com/en/products/result?keywords=CRCW04021M00FKED
39 | R25 | 10k | Resistor_SMD:R_0603_1608Metric | 1 | Primary | Primary Approved | UniOhm/Uniohm | 0603WAF1002T5E |  | 0603 | 10 kΩ, 1%, ≥0.1 W | Very high / commodity | <$0.01 typical | Drop-in |  | https://www.lcsc.com/search?q=0603WAF1002T5E
39 | R25 | 10k | Resistor_SMD:R_0603_1608Metric | 2 | Alternative 1 | Approved Alternate | Yageo | RC0603FR-0710KL |  | 0603 | 10 kΩ, 1%, ≥0.1 W | High / commodity |  | Drop-in |  | https://www.digikey.com/en/products/result?keywords=RC0603FR-0710KL
39 | R25 | 10k | Resistor_SMD:R_0603_1608Metric | 3 | Alternative 2 | Approved Alternate | Panasonic | ERJ-3EKF1002V |  | 0603 | 10 kΩ, 1%, ≥0.1 W | High / commodity |  | Drop-in |  | https://www.digikey.com/en/products/result?keywords=ERJ-3EKF1002V
39 | R25 | 10k | Resistor_SMD:R_0603_1608Metric | 4 | Alternative 3 | Approved Alternate | Vishay | CRCW060310K0FKEA |  | 0603 | 10 kΩ, 1%, ≥0.1 W | High / commodity |  | Drop-in |  | https://www.digikey.com/en/products/result?keywords=CRCW060310K0FKEA
40 | R26 | 10kΩ | Resistor_SMD:R_0402_1005Metric | 1 | Primary | Primary Approved | UniOhm/Uniohm | 0402WGF1002TCE |  | 0402 | 10 kΩ, 1%, ≥0.063 W | Very high / commodity | <$0.01 typical | Drop-in |  | https://www.lcsc.com/search?q=0402WGF1002TCE
40 | R26 | 10kΩ | Resistor_SMD:R_0402_1005Metric | 2 | Alternative 1 | Approved Alternate | Yageo | RC0402FR-0710KL |  | 0402 | 10 kΩ, 1%, ≥0.063 W | High / commodity |  | Drop-in |  | https://www.digikey.com/en/products/result?keywords=RC0402FR-0710KL
40 | R26 | 10kΩ | Resistor_SMD:R_0402_1005Metric | 3 | Alternative 2 | Approved Alternate | Panasonic | ERJ-2RKF1002X |  | 0402 | 10 kΩ, 1%, ≥0.063 W | High / commodity |  | Drop-in |  | https://www.digikey.com/en/products/result?keywords=ERJ-2RKF1002X
40 | R26 | 10kΩ | Resistor_SMD:R_0402_1005Metric | 4 | Alternative 3 | Approved Alternate | Vishay | CRCW040210K0FKED |  | 0402 | 10 kΩ, 1%, ≥0.063 W | High / commodity |  | Drop-in |  | https://www.digikey.com/en/products/result?keywords=CRCW040210K0FKED
41 | R28 | 100kΩ | Resistor_SMD:R_0603_1608Metric | 1 | Primary | Primary Approved | UniOhm/Uniohm | 0603WAF1003T5E |  | 0603 | 100 kΩ, 1%, ≥0.1 W | Very high / commodity | <$0.01 typical | Drop-in |  | https://www.lcsc.com/search?q=0603WAF1003T5E
41 | R28 | 100kΩ | Resistor_SMD:R_0603_1608Metric | 2 | Alternative 1 | Approved Alternate | Yageo | RC0603FR-07100KL |  | 0603 | 100 kΩ, 1%, ≥0.1 W | High / commodity |  | Drop-in |  | https://www.digikey.com/en/products/result?keywords=RC0603FR-07100KL
41 | R28 | 100kΩ | Resistor_SMD:R_0603_1608Metric | 3 | Alternative 2 | Approved Alternate | Panasonic | ERJ-3EKF1003V |  | 0603 | 100 kΩ, 1%, ≥0.1 W | High / commodity |  | Drop-in |  | https://www.digikey.com/en/products/result?keywords=ERJ-3EKF1003V
41 | R28 | 100kΩ | Resistor_SMD:R_0603_1608Metric | 4 | Alternative 3 | Approved Alternate | Vishay | CRCW0603100KFKEA |  | 0603 | 100 kΩ, 1%, ≥0.1 W | High / commodity |  | Drop-in |  | https://www.digikey.com/en/products/result?keywords=CRCW0603100KFKEA
42 | SW5 | ENABLE | Button_Switch_THT:SW_PUSH_6mm_H5mm | 1 | Primary | Proposed / Not Released | Omron | B3F-1000 |  | 6 x 6 mm THT tactile | Momentary NO, 4.3 mm body height | Very high |  | Matches common SW_PUSH_6mm footprint; verify height |  | https://www.digikey.com/en/products/result?keywords=B3F-1000
42 | SW5 | ENABLE | Button_Switch_THT:SW_PUSH_6mm_H5mm | 2 | Alternative 1 | Conditional Alternate | Omron | B3F-1020 |  | 6 x 6 mm THT tactile | Momentary NO, taller actuator | Very high |  | Drop-in pads; verify height |  | https://www.digikey.com/en/products/result?keywords=B3F-1020
42 | SW5 | ENABLE | Button_Switch_THT:SW_PUSH_6mm_H5mm | 3 | Alternative 2 | Conditional Alternate | E-Switch | TL1105SPF250QG |  | 6 x 6 mm THT tactile | Momentary NO, 5 mm class actuator | High |  | Verify exact pin spacing/height |  | https://www.digikey.com/en/products/result?keywords=TL1105SPF250QG
42 | SW5 | ENABLE | Button_Switch_THT:SW_PUSH_6mm_H5mm | 4 | Alternative 3 | Conditional Alternate | C&K | PTS645SL43SMTR92 LFS |  | 6 x 6 mm tactile | Momentary NO | High |  | Package variant may be SMT; verify before order |  | https://www.digikey.com/en/products/result?keywords=PTS645SL43SMTR92+LFS
43 | SW6 | RESET | Button_Switch_THT:SW_PUSH_6mm_H5mm | 1 | Primary | Proposed / Not Released | Omron | B3F-1000 |  | 6 x 6 mm THT tactile | Momentary NO, 4.3 mm body height | Very high |  | Matches common SW_PUSH_6mm footprint; verify height |  | https://www.digikey.com/en/products/result?keywords=B3F-1000
43 | SW6 | RESET | Button_Switch_THT:SW_PUSH_6mm_H5mm | 2 | Alternative 1 | Conditional Alternate | Omron | B3F-1020 |  | 6 x 6 mm THT tactile | Momentary NO, taller actuator | Very high |  | Drop-in pads; verify height |  | https://www.digikey.com/en/products/result?keywords=B3F-1020
43 | SW6 | RESET | Button_Switch_THT:SW_PUSH_6mm_H5mm | 3 | Alternative 2 | Conditional Alternate | E-Switch | TL1105SPF250QG |  | 6 x 6 mm THT tactile | Momentary NO, 5 mm class actuator | High |  | Verify exact pin spacing/height |  | https://www.digikey.com/en/products/result?keywords=TL1105SPF250QG
43 | SW6 | RESET | Button_Switch_THT:SW_PUSH_6mm_H5mm | 4 | Alternative 3 | Conditional Alternate | C&K | PTS645SL43SMTR92 LFS |  | 6 x 6 mm tactile | Momentary NO | High |  | Package variant may be SMT; verify before order |  | https://www.digikey.com/en/products/result?keywords=PTS645SL43SMTR92+LFS
44 | U1 | ESP32-WROOM-32UE | RF_Module:ESP32-WROOM-32UE | 1 | Primary | Primary Approved | Espressif | ESP32-WROOM-32UE-N8 | C701345 | ESP32-WROOM-32UE module | 8 MB flash, external antenna connector | JLC listed / high |  | Drop-in |  | https://jlcpcb.com/partdetail/EspressifSystems-ESP32_WROOM_32UE_N8/C701345
44 | U1 | ESP32-WROOM-32UE | RF_Module:ESP32-WROOM-32UE | 2 | Alternative 1 | Approved Alternate | Espressif | ESP32-WROOM-32UE-N4 | C701344 | ESP32-WROOM-32UE module | 4 MB flash, external antenna connector | JLC listed |  | Drop-in; lower flash |  | https://jlcpcb.com/partdetail/EspressifSystems-ESP32_WROOM_32UE_N4/C701344
44 | U1 | ESP32-WROOM-32UE | RF_Module:ESP32-WROOM-32UE | 3 | Alternative 2 | Approved Alternate | Espressif | ESP32-WROOM-32UE-N16 | C701346 | ESP32-WROOM-32UE module | 16 MB flash, external antenna connector | JLC listed |  | Drop-in; firmware partition change may be useful |  | https://jlcpcb.com/partdetail/EspressifSystems-ESP32_WROOM_32UE_N16/C701346
44 | U1 | ESP32-WROOM-32UE | RF_Module:ESP32-WROOM-32UE | 4 | Alternative 3 | Approved Alternate | Espressif | ESP32-WROOM-32UE-N8R2 | C6946018 | ESP32-WROOM-32UE module | 8 MB flash + PSRAM variant; verify firmware target | JLC listed |  | Drop-in hardware; firmware config change |  | https://jlcpcb.com/partdetail/EspressifSystems-ESP32_WROOM_32UE_N8R2/C6946018
45 | U2 | ULN2803A | Package_SO:SOIC-18W_7.5x11.6mm_P1.27mm | 1 | Primary | Primary Approved | Mixic | ULN2803A | C107219 | SOP-18 300 mil | 8-channel Darlington sink array, 50 V, 500 mA/channel class | JLC high | <$0.10 typical | Drop-in |  | https://jlcpcb.com/partdetail/Mixic-ULN2803A/C107219
45 | U2 | ULN2803A | Package_SO:SOIC-18W_7.5x11.6mm_P1.27mm | 2 | Alternative 1 | Approved Alternate | UMW | ULN2803A | C845537 | SOP-18 300 mil | 8-channel Darlington sink array, 50 V class | JLC listed |  | Drop-in |  | https://jlcpcb.com/partdetail/UMW-ULN2803A/C845537
45 | U2 | ULN2803A | Package_SO:SOIC-18W_7.5x11.6mm_P1.27mm | 3 | Alternative 2 | Approved Alternate | Texas Instruments | ULN2803ADWR |  | SOIC-18 wide | 8-channel Darlington sink array, 50 V, 500 mA/channel | Very high |  | Drop-in |  | https://www.digikey.com/en/products/result?keywords=ULN2803ADWR
45 | U2 | ULN2803A | Package_SO:SOIC-18W_7.5x11.6mm_P1.27mm | 4 | Alternative 3 | Conditional Alternate | STMicroelectronics | ULN2803AD1013TR |  | SO-18 wide | 8-channel Darlington sink array, 50 V class | Very high |  | Drop-in; verify footprint courtyard |  | https://www.digikey.com/en/products/result?keywords=ULN2803AD1013TR
46 | U3 | W5500 | Package_QFP:LQFP-48_7x7mm_P0.5mm | 1 | Primary | Primary Approved | WIZnet | W5500 | C32843 | LQFP-48 7x7 | Hardwired TCP/IP Ethernet controller, 3.3 V, integrated 10/100 PHY | JLC high | ~$2-$4 | Drop-in |  | https://jlcpcb.com/partdetail/WIZnet-W5500/C32843
46 | U3 | W5500 | Package_QFP:LQFP-48_7x7mm_P0.5mm | 2 | Alternative 1 | Approved Alternate | WIZnet | W5500 |  | LQFP-48 7x7 | Same silicon sourced from authorized distributor | Very high |  | Drop-in / alternate supply channel |  | https://www.digikey.com/en/products/detail/wiznet/W5500/4425708
46 | U3 | W5500 | Package_QFP:LQFP-48_7x7mm_P0.5mm | 3 | Alternative 2 | Redesign Only | WIZnet | W5100S-L |  | LQFP-48 | Hardwired TCP/IP Ethernet controller | High |  | Not drop-in: pinout/firmware review |  | https://www.digikey.com/en/products/result?keywords=W5100S-L
46 | U3 | W5500 | Package_QFP:LQFP-48_7x7mm_P0.5mm | 4 | Alternative 3 | Redesign Only | Microchip | ENC28J60-I/ML |  | QFN-28 | 10BASE-T Ethernet controller | High |  | Full redesign: package, PHY interface, firmware |  | https://www.digikey.com/en/products/result?keywords=ENC28J60-I%2FML
47 | U4 | 3A 32V | Fuse:Fuse_1206_3216Metric | 1 | Primary | Primary - Verify | Bel Fuse | 0685F3000-01 |  | 1206 | 3 A, fast-acting C1F series; verify 63 V DC rating | High distributor availability |  | Drop-in |  | https://www.digikey.com/en/products/result?keywords=0685F3000-01
47 | U4 | 3A 32V | Fuse:Fuse_1206_3216Metric | 2 | Alternative 1 | Approved Alternate | Bourns | SF-1206F300-2 |  | 1206 | 3 A fast-acting chip fuse; verify DC interrupt rating | High |  | Drop-in |  | https://www.digikey.com/en/products/result?keywords=SF-1206F300-2
47 | U4 | 3A 32V | Fuse:Fuse_1206_3216Metric | 3 | Alternative 2 | Approved Alternate | Eaton | CC12H3A-TR |  | 1206 | 3 A chip fuse; verify speed/DC rating | High |  | Drop-in |  | https://www.digikey.com/en/products/result?keywords=CC12H3A-TR
47 | U4 | 3A 32V | Fuse:Fuse_1206_3216Metric | 4 | Alternative 3 | Approved Alternate | Littelfuse | 0467003.NRHF |  | 1206 | 3 A chip fuse; verify speed/DC rating | High |  | Drop-in |  | https://www.digikey.com/en/products/result?keywords=0467003.NRHF
48 | U5 | TPS630701RNMR | Library:RNM0015A | 1 | Primary | Primary Approved | Texas Instruments | TPS630701RNMR | C2876599 | VQFN-HR-15, 3x2.5 mm | Fixed 5 V buck-boost, 2-16 V input, 2 A output class | JLC stock reported high | ~$1.27 | Drop-in |  | https://jlcpcb.com/partdetail/TexasInstruments-TPS630701RNMR/C2876599
48 | U5 | TPS630701RNMR | Library:RNM0015A | 2 | Alternative 1 | Approved Alternate | Texas Instruments | TPS630701RNMT |  | VQFN-HR-15, 3x2.5 mm | Same fixed 5 V device, alternate reel quantity | High distributor availability |  | Drop-in |  | https://www.digikey.com/en/products/result?keywords=TPS630701RNMT
48 | U5 | TPS630701RNMR | Library:RNM0015A | 3 | Alternative 2 | Conditional Alternate | Texas Instruments | TPS63070RNMR |  | VQFN-HR-15, 3x2.5 mm | Adjustable 2.5-9 V buck-boost | High |  | Same package; schematic/BOM feedback network change |  | https://www.digikey.com/en/products/result?keywords=TPS63070RNMR
48 | U5 | TPS630701RNMR | Library:RNM0015A | 4 | Alternative 3 | Conditional Alternate | Texas Instruments | TPS630702RNMR | C2071354 | VQFN-HR-15, 3x2.5 mm | Adjustable/variant buck-boost | JLC listed |  | Same package; configuration review required |  | https://jlcpcb.com/partdetail/TexasInstruments-TPS630702RNMR/C2071354
49 | U7 | TVS1800DRVR | Library:DRV0006A_NV | 1 | Primary | Proposed / Not Released | Texas Instruments | TVS1400DRVR | C1975229 | WSON-6 2x2 | 14 V standoff flat-clamp TVS, 19.3 V max clamp at specified surge | JLC stock ~2k at research time | ~$0.39 | Same footprint; engineering review required | Better coordinated than TVS1800 for a 12 V rail, but its worst-case clamp still exceeds the TPS63070 16 V recommended input range; verify absolute maximum, surge impedance, fuse/series resistance, and test waveform. | https://jlcpcb.com/partdetail/TVS1400DRVR/C1975229
49 | U7 | TVS1800DRVR | Library:DRV0006A_NV | 2 | Alternative 1 | Conditional Alternate | Texas Instruments | TVS1400DRVT |  | WSON-6 2x2 | Same TVS1400 silicon, alternate package quantity | High distributor availability |  | Same footprint; engineering review required |  | https://www.digikey.com/en/products/result?keywords=TVS1400DRVT
49 | U7 | TVS1800DRVR | Library:DRV0006A_NV | 3 | Alternative 2 | Approved Alternate | Texas Instruments | TVS1800DRVR |  | WSON-6 2x2 | 18 V standoff, ~24.7 V max clamp | DigiKey/Mouser stock high | ~$1.10 single | Drop-in but not recommended for protecting TPS63070 input |  | https://www.digikey.com/en/products/detail/texas-instruments/TVS1800DRVR/8601784
49 | U7 | TVS1800DRVR | Library:DRV0006A_NV | 4 | Alternative 3 | Redesign Only | Littelfuse / equivalent | SMAJ12A |  | SMA | 12 V standoff, high pulse-power TVS | Very high / commodity | <$0.10 typical | Layout change; protection coordination still required |  | https://www.digikey.com/en/products/result?keywords=SMAJ12A
50 | U9,U10 | TLV1117LV33DCYR | Library:TLV1117-33IDCYR | 1 | Primary | Primary Approved | Texas Instruments | TLV1117LV33DCYR | C15578 | SOT-223-4 | 3.3 V fixed, 1 A, VIN 2-5.5 V, ceramic stable | LCSC/JLC availability good | ~$0.21-$0.37 | Drop-in |  | https://www.lcsc.com/product-detail/Low-Dropout-Regulators-LDO_TI_TLV1117LV33DCYR_TLV1117LV33DCYR_C15578.html
50 | U9,U10 | TLV1117LV33DCYR | Library:TLV1117-33IDCYR | 2 | Alternative 1 | Approved Alternate | Texas Instruments | TLV1117LV33DCYT |  | SOT-223-4 | Same 3.3 V TLV1117LV, smaller reel/cut-tape orderable | High |  | Drop-in |  | https://www.digikey.com/en/products/result?keywords=TLV1117LV33DCYT
50 | U9,U10 | TLV1117LV33DCYR | Library:TLV1117-33IDCYR | 3 | Alternative 2 | Conditional Alternate | Texas Instruments | TLV76133DCYR |  | SOT-223 | 3.3 V LDO; TI-listed upgrade path | High |  | Likely pin-compatible; recheck capacitors and thermal |  | https://www.digikey.com/en/products/result?keywords=TLV76133DCYR
50 | U9,U10 | TLV1117LV33DCYR | Library:TLV1117-33IDCYR | 4 | Alternative 3 | Conditional Alternate | Diodes Incorporated | AP1117E33G-13 |  | SOT-223 | 3.3 V, 1 A-class 1117 LDO | Very high |  | Pin-compatible class; higher VIN/IQ and stability differ |  | https://www.digikey.com/en/products/result?keywords=AP1117E33G-13
51 | Y2 | ABM3C-25.000MHZ-D4Y-T | Library:CRYSTAL_ABM3C_ABR-M | 1 | Primary | Primary - Verify | HCI | XC53M4-25.000-F18NJDTL | C2962760 | 5032 4-pad | 25 MHz, 18 pF load, 50 Ω class, -40 to 85°C | JLC listed; order-time stock check |  | Drop-in |  | https://jlcpcb.com/partdetail/HCI-XC53M4_25000_F18NJDTL/C2962760
51 | Y2 | ABM3C-25.000MHZ-D4Y-T | Library:CRYSTAL_ABM3C_ABR-M | 2 | Alternative 1 | Approved Alternate | Slkor | SL503225M18P | C5155495 | 5032 4-pad | 25 MHz, 18 pF load, ~40 Ω, -20 to 70°C | JLC stock reported ~981 | ~$0.20 | Drop-in if temperature range is acceptable |  | https://jlcpcb.com/partdetail/Slkor-SL503225M18P/C5155495
51 | Y2 | ABM3C-25.000MHZ-D4Y-T | Library:CRYSTAL_ABM3C_ABR-M | 3 | Alternative 2 | Approved Alternate | Abracon | ABM3C-25.000MHZ-D4Y-T | C596885 | 5032 4-pad | 25 MHz, 18 pF load, 50 Ω, -40 to 85°C | JLC stock was extremely low at research time | ~$0.46 | Drop-in |  | https://jlcpcb.com/partdetail/Abracon-ABM3C_25000MHZ_D4Y_T/C596885
51 | Y2 | ABM3C-25.000MHZ-D4Y-T | Library:CRYSTAL_ABM3C_ABR-M | 4 | Alternative 3 | Approved Alternate | Abracon | ABM3B-25.000MHZ-D-4-H-T | C5936389 | 5032 4-pad | 25 MHz crystal; verify CL/ESR exact suffix | Low/variable |  | Drop-in only if CL/ESR meet W5500 design |  | https://jlcpcb.com/partdetail/Abracon-ABM3B_25000MHZ_D_4_H_T/C5936389

Sheet: Source BOM
Reference | Value | Datasheet | Footprint | Qty | DNP
C1,C8,C26,C27 | 10uF | CL21A106KOQNNNE | Capacitor_SMD:C_0805_2012Metric | 4
C2,C28,C29 | 10uF | CL21A106KOQNNNE | Capacitor_SMD:C_0603_1608Metric | 3
C3,C4 | 0.1uF |  | Capacitor_SMD:C_0603_1608Metric | 2
C5 | 4.7uF - Eth Reference Cap |  | Capacitor_SMD:C_0201_0603Metric | 1
C6 | 22nF |  | Capacitor_SMD:C_0201_0603Metric | 1
C7 | 0.1uF |  | Capacitor_SMD:C_0201_0603Metric | 1
C9 | 100uF - Electrolytic |  | Capacitor_SMD:C_Elec_6.3x7.7 | 1
C10 | 100nF - Ceramic |  | Capacitor_SMD:C_0603_1608Metric | 1
C11,C12,C13,C14,C15,C16 | 0.1uF |  | Capacitor_SMD:C_0402_1005Metric | 6
C17,C19 | 6.8nF |  | Capacitor_SMD:C_0201_0603Metric | 2
C18 | 10uF / 16V |  | Capacitor_SMD:C_0805_2012Metric | 1
C20,C23 | 10nF |  | Capacitor_SMD:C_0201_0603Metric | 2
C21,C22 | 18pF |  | Capacitor_SMD:C_0201_0603Metric | 2
C24 | 1uF - Ceramic |  | Capacitor_SMD:C_0805_2012Metric | 1
C25 | 100nF |  | Capacitor_SMD:C_0201_0603Metric | 1
C30,C31 | 22uF | CL21A106KOQNNNE | Capacitor_SMD:C_0805_2012Metric | 2
C32,C33,C34,C35 | 1uF |  | Capacitor_SMD:C_0805_2012Metric | 4
C36,C37 | 1uF |  | Capacitor_SMD:C_0402_1005Metric | 2
D1,D2,D3,D4,D5 | LED VO-PT2012SEAC |  | LED_SMD:LED_0201_0603Metric | 5
D6 | LED |  | LED_SMD:LED_0201_0603Metric | 1
F1,F2,F5 | 0685T5000 |  | Fuse:Fuse_0805_2012Metric | 3
F3,F4 | 0685T5000-01 |  | Fuse:Fuse_0805_2012Metric | 2
J1 | 12 |  | Connector_BarrelJack:BarrelJack_CUI_PJ-102AH_Horizontal | 1
J2 | RJ45_Hanrun_HR911105A_Horizontal | https://datasheet.lcsc.com/lcsc/1811141815_HANRUN-Zhongshan-HanRun-Elec-HR911105A_C12074.pdf | Connector_RJ:RJ45_Hanrun_HR911105A_Horizontal | 1
J3 | B4B-PH-SM4-TB | B4B-PH-SM4-TB | Connector_PinHeader_2.54mm:PinHeader_1x04_P2.54mm_Vertical | 1
J10,J11,J12,J13,J14 | Screw_Terminal_01x03 |  | TerminalBlock:TerminalBlock_MaiXu_MX126-5.0-03P_1x03_P5.00mm | 5
K10,K11,K12,K13,K14 | G2RL-1-E | https://omronfs.omron.com/en_US/ecb/products/pdf/en-g2rl.pdf | Relay_THT:Relay_SPDT_Omron_G2RL-1-E | 5
L1 | MH1608-121Y |  | Library:IND_BOURNS_MH1608 | 1
L3 | XFL4020-152MEC | XFL4020-152MEC | Library:IND_XFL4020_COC-M | 1
R1,R2,R3,R4,R5 | 2.2k |  | Resistor_SMD:R_0603_1608Metric | 5
R6 | 12.4k 1% - Ethernet external reference |  | Resistor_SMD:R_0402_1005Metric | 1
R7,R8,R16,R17 | 33 |  | Resistor_SMD:R_0603_1608Metric | 4
R9,R15,R29 | 330 |  | Resistor_SMD:R_0603_1608Metric | 3
R10,R11,R12,R13,R14 | 100k |  | Resistor_SMD:R_0603_1608Metric | 5
R18,R19,R21,R22 | 49.9 1% |  | Resistor_SMD:R_0201_0603Metric | 4
R20 | 10 1% |  | Resistor_SMD:R_0201_0603Metric | 1
R23 | 0 |  | Resistor_SMD:R_0402_1005Metric | 1
R24 | 1M |  | Resistor_SMD:R_0402_1005Metric | 1
R25 | 10k |  | Resistor_SMD:R_0603_1608Metric | 1
R26 | 10kΩ |  | Resistor_SMD:R_0402_1005Metric | 1
R28 | 100kΩ |  | Resistor_SMD:R_0603_1608Metric | 1
SW5 | ENABLE | PTS815 SJM 250 SMTR LFS | Button_Switch_THT:SW_PUSH_6mm_H5mm | 1
SW6 | RESET | PTS815 SJM 250 SMTR LFS | Button_Switch_THT:SW_PUSH_6mm_H5mm | 1
U1 | ESP32-WROOM-32UE | https://www.espressif.com/sites/default/files/documentation/esp32-wroom-32e_esp32-wroom-32ue_datasheet_en.pdf | RF_Module:ESP32-WROOM-32UE | 1
U2 | ULN2803A | http://www.ti.com/lit/ds/symlink/uln2803a.pdf | Package_SO:SOIC-18W_7.5x11.6mm_P1.27mm | 1
U3 | W5500 | https://docs.wiznet.io/img/products/w5500/W5500_ds_v110e.pdf | Package_QFP:LQFP-48_7x7mm_P0.5mm | 1
U4 | 3A 32V | C1F 3 | Fuse:Fuse_1206_3216Metric | 1
U5 | TPS630701RNMR | https://www.ti.com/lit/gpn/tps63070 | Library:RNM0015A | 1
U7 | TVS1800DRVR | https://www.ti.com/lit/gpn/tvs1800 | Library:DRV0006A_NV | 1
U9,U10 | TLV1117LV33DCYR | https://www.ti.com/lit/gpn/tlv1117lv | Library:TLV1117-33IDCYR | 2
Y2 | ABM3C-25.000MHZ-D4Y-T | https://abracon.com/Resonators/ABM3C.pdf | Library:CRYSTAL_ABM3C_ABR-M | 1
