StickOnAStick/48VRelay_essential/RelatBoard/48VRelay/48VERelay/_restore_backup_2026-08-07T21-41-39-209/BOM/48VRelay_Manufacturing_BOM_RevD.xlsx

Sheet: Overview
48V Relay PCBA — Manufacturing BOM
Revision basis | Rev D — package and engineering approvals incorporated
Generated | 2026-07-22
BOM lines | 51
Total placements | 102
Ready | 45
Verify | 6
Blocker | 0
Engineering hold | 0
Release structure
File | Purpose
Manufacturing BOM | One selected primary part per BOM line; no alternates embedded.
JLC Import Draft | JLC-style columns using the selected primary. Do not release while BLOCKER or ENGINEERING HOLD rows remain.
Release Holds | All non-READY items and the action needed before production.
Source BOM | The revised CSV preserved unchanged for traceability.
AVL file | All three alternatives per line are maintained in the separate Approved Vendor List workbook.
Release warning
Release status | All footprint blockers and the TVS hold are resolved. Remaining VERIFY rows are procurement or final configuration checks.
Rev D decisions | D1–D5: orange 0805; D6: low-power red 0201; F1–F5: 1206 5 A / 63 V slow-blow; TVS1400, crystal, relay contacts and screw terminals approved.

Sheet: Manufacturing BOM
Line | Comment / Value | Designator | Footprint | Qty | DNP | Manufacturer | Manufacturer Part Number | LCSC/JLCPCB Part # | Package | Key Specifications | Release Status | Compatibility | Procurement / Engineering Note | Source URL | Original Datasheet / Entry
1 | 10uF | C1,C8,C26,C27 | Capacitor_SMD:C_0805_2012Metric | 4 |  | Samsung Electro-Mechanics | CL21A106KOQNNNE | C1713 | 0805 | 10 µF, 16 V, X5R, ±10% | READY | Drop-in | Package split resolved. Use the 0805 MPN only on these references; verify DC-bias derating at the actual rail. | https://jlcpcb.com/partdetail/CL21A106KOQNNNE/C1713 | CL21A106KOQNNNE
2 | 10uF | C2,C28,C29 | Capacitor_SMD:C_0603_1608Metric | 3 |  | Murata | GRM188R61C106KAALD | C86275 | 0603 | 10 µF, 16 V, X5R, ±10% | VERIFY | Drop-in | Package split resolved. 10 µF in 0603 is strongly DC-bias dependent; confirm effective capacitance at each actual rail voltage. | https://jlcpcb.com/partdetail/MurataElectronics-GRM188R61C106KAALD/C86275 | CL21A106KOQNNNE
3 | 0.1uF | C3,C4 | Capacitor_SMD:C_0603_1608Metric | 2 |  | Yageo | CC0603KRX7R9BB104 | C14663 | 0603 | 100 nF, 50 V, X7R, ±10% | READY | Drop-in | Package split resolved; same primary also used for C10 to reduce unique line items. | https://jlcpcb.com/partdetail/CC0603KRX7R9BB104/C14663
4 | 4.7uF - Eth Reference Cap | C5 | Capacitor_SMD:C_0201_0603Metric | 1 |  | Murata | GRM033R60J475ME05D |  | 0201 | 4.7 µF, 6.3 V, X5R, ±20% | VERIFY | Drop-in | 4.7 µF in 0201 is specialty and strongly DC-bias dependent. Confirm the W5500 reference node voltage and effective capacitance; 0402/0603 is safer if layout permits. Check effective capacitance under DC bias; 0201 assembly is less forgiving. | https://www.digikey.com/en/products/detail/murata-electronics/GRM033R60J475ME05D/16033659
5 | 22nF | C6 | Capacitor_SMD:C_0201_0603Metric | 1 |  | Murata | GRM033R71H223KA12D |  | 0201 | 22 nF, 50 V, X7R, ±10% | READY | Drop-in | Commodity X7R. Keep 50 V rating for margin. | https://www.digikey.com/en/products/result?keywords=GRM033R71H223KA12D
6 | 0.1uF | C7 | Capacitor_SMD:C_0201_0603Metric | 1 |  | Samsung Electro-Mechanics | CL03A104KA3NNNC | C307379 | 0201 | 100 nF, 25 V, X5R, ±10% | READY | Drop-in | Package split resolved. JLC normally treats 0201 assembly as Standard PCBA; verify effective capacitance only if used on a higher-bias node. | https://jlcpcb.com/partdetail/291053-CL03A104KA3NNNC/C307379
7 | 100uF - Electrolytic | C9 | Capacitor_SMD:C_Elec_6.3x7.7 | 1 |  | Panasonic | EEE-FK1E101P |  | 6.3 x 7.7 mm SMD can | 100 µF, 25 V, low-ESR aluminum electrolytic | VERIFY | Mechanical match; verify land pattern | Assumed 12 V input bulk capacitor; use ≥25 V and verify ESR/ripple-current and exact 6.3 x 7.7 mm land pattern. | https://www.digikey.com/en/products/result?keywords=EEE-FK1E101P
8 | 100nF - Ceramic | C10 | Capacitor_SMD:C_0603_1608Metric | 1 |  | Yageo | CC0603KRX7R9BB104 | C14663 | 0603 | 100 nF, 50 V, X7R, ±10% | READY | Drop-in | Commodity 50 V X7R. | https://jlcpcb.com/partdetail/CC0603KRX7R9BB104/C14663
9 | 0.1uF | C11,C12,C13,C14,C15,C16 | Capacitor_SMD:C_0402_1005Metric | 6 |  | Samsung Electro-Mechanics | CL05B104KO5NNNC | C1525 | 0402 | 100 nF, 16 V, X7R, ±10% | READY | Drop-in | Package split resolved. 16 V rating is adequate for the 3.3 V/5 V decoupling use implied here; use a 50 V alternative if any reference is on a higher rail. | https://jlcpcb.com/parts/basic_parts/
10 | 6.8nF | C17,C19 | Capacitor_SMD:C_0201_0603Metric | 2 |  | Murata | GRM033R71H682KA12D |  | 0201 | 6.8 nF, 50 V, X7R, ±10% | READY | Drop-in | Commodity X7R; verify W5500 network value against schematic. | https://www.digikey.com/en/products/result?keywords=GRM033R71H682KA12D
11 | 10uF / 16V | C18 | Capacitor_SMD:C_0805_2012Metric | 1 |  | Samsung Electro-Mechanics | CL21A106KOQNNNE |  | 0805 | 10 µF, 16 V, X5R, ±10% | READY | Drop-in | Use 16 V minimum; evaluate DC-bias derating at the actual rail. | https://www.digikey.com/en/products/detail/samsung-electro-mechanics/CL21A106KOQNNNE/3886754
12 | 10nF | C20,C23 | Capacitor_SMD:C_0201_0603Metric | 2 |  | Murata | GRM033R71H103KA12D |  | 0201 | 10 nF, 50 V, X7R, ±10% | READY | Drop-in | Commodity X7R. | https://www.digikey.com/en/products/result?keywords=GRM033R71H103KA12D
13 | 18pF | C21,C22 | Capacitor_SMD:C_0201_0603Metric | 2 |  | Murata | GRM0335C1H180JA01D |  | 0201 | 18 pF, 50 V, C0G/NP0, ±5% | READY | Drop-in | Use C0G/NP0 for crystal load capacitors. | https://www.digikey.com/en/products/result?keywords=GRM0335C1H180JA01D
14 | 1uF - Ceramic | C24 | Capacitor_SMD:C_0805_2012Metric | 1 |  | Samsung Electro-Mechanics | CL21A105KAFNNNE | C95840 | 0805 | 1 µF, 25 V, X5R, ±10% | READY | Drop-in | 25 V X7R preferred for broad reuse. | https://jlcpcb.com/partdetail/97044-CL21A105KAFNNNE/C95840
15 | 100nF | C25 | Capacitor_SMD:C_0201_0603Metric | 1 |  | Samsung Electro-Mechanics | CL03A104KA3NNNC | C307379 | 0201 | 100 nF, 25 V, X5R, ±10% | READY | Drop-in | Consolidated with C7. JLC normally treats 0201 assembly as Standard PCBA. | https://jlcpcb.com/partdetail/291053-CL03A104KA3NNNC/C307379
16 | 22uF | C30,C31 | Capacitor_SMD:C_0805_2012Metric | 2 |  | Murata | GRM21BR61A226ME44K |  | 0805 | 22 µF, 10 V, X5R, ±20% | VERIFY | Drop-in | Primary MPN corrected to a true 22 µF 0805 part. Verify 10 V rating and effective capacitance at the actual rail voltage. | https://www.digikey.com/en/products/detail/murata-electronics/GRM21BR61A226ME44K/26223516 | CL21A106KOQNNNE
17 | 1uF | C32,C33,C34,C35 | Capacitor_SMD:C_0805_2012Metric | 4 |  | Samsung Electro-Mechanics | CL21A105KAFNNNE | C95840 | 0805 | 1 µF, 25 V, X5R, ±10% | READY | Drop-in | Package split resolved; same primary also used for C24 to reduce unique parts. | https://jlcpcb.com/partdetail/97044-CL21A105KAFNNNE/C95840
18 | 1uF | C36,C37 | Capacitor_SMD:C_0402_1005Metric | 2 |  | Samsung Electro-Mechanics | CL05A105KO5NNNC | C29266 | 0402 | 1 µF, 16 V, X5R, ±10% | READY | Drop-in | Package split resolved. Verify DC-bias derating if the capacitor is used as bulk rather than local decoupling. | https://jlcpcb.com/partdetail/C29266
19 | LED Orange 0805 | D1,D2,D3,D4,D5 | LED_SMD:LED_0805_2012Metric | 5 |  | LITEON | LTST-C170KFKT | C284931 | 0805 (2012 metric) | Orange, 605 nm, 2.0 V typical, 20 mA max, 45–90 mcd | READY | Drop-in | Approved 0805 relay indicator LED. The circuit rail is 12 V; the LED current must still be limited by the series resistor. Verify polarity and target brightness. | https://www.lcsc.com/product-detail/C284931.html | User-approved 0805 package; replaces VO-PT2012SEAC intent
20 | LED Red Low-Power 0201 | D6 | LED_SMD:LED_0201_0603Metric | 1 |  | Lite-On | LTST-FC03ED-5A | C20617267 | 0201 (0603 metric) | Red low-power indicator LED, 0201 | READY | Drop-in | Approved as the low-power 0201 status LED. Verify polarity and set the resistor for the intended low operating current. | https://jlcpcb.com/partdetail/LiteOn-LTST_FC03ED5A/C20617267 | User-approved low-power 0201 LED
21 | 5A 63V Slow-Blow Fuse | F1,F2,F5 | Fuse:Fuse_1206_3216Metric | 3 |  | SART | S1206-SD-5.0A | C553937 | 1206 (3216 metric) | 5 A, 63 VDC, slow-blow, 50 A interrupt rating, -55 to 125 °C | READY | Drop-in after 1206 footprint change | Approved 1206 layout. Primary selected for JLC availability and the required 5 A / 63 VDC slow-blow rating. | https://jlcpcb.com/partdetail/SART_Nanjing_Sart_Tech-S1206_SD_50A/C553937 | Replaces Bel 0685T5000-01 as JLC production primary
22 | 5A 63V Slow-Blow Fuse | F3,F4 | Fuse:Fuse_1206_3216Metric | 2 |  | SART | S1206-SD-5.0A | C553937 | 1206 (3216 metric) | 5 A, 63 VDC, slow-blow, 50 A interrupt rating, -55 to 125 °C | READY | Drop-in after 1206 footprint change | Approved 1206 layout. Primary selected for JLC availability and the required 5 A / 63 VDC slow-blow rating. | https://jlcpcb.com/partdetail/SART_Nanjing_Sart_Tech-S1206_SD_50A/C553937 | Replaces Bel 0685T5000-01 as JLC production primary
23 | 12 | J1 | Connector_BarrelJack:BarrelJack_CUI_PJ-102AH_Horizontal | 1 |  | Same Sky / CUI Devices | PJ-102AH | C9900001188 | THT horizontal barrel jack | 2.0 mm center pin, switched contact; verify adapter plug/current | VERIFY | Drop-in | Exact jack can be sourced, but JLC availability may require pre-order/consignment. Confirm adapter plug size, polarity, current, and switched-pin use. | https://jlcpcb.com/partdetail/CUIDevices-PJ102AH/C9900001188
24 | RJ45_Hanrun_HR911105A_Horizontal | J2 | Connector_RJ:RJ45_Hanrun_HR911105A_Horizontal | 1 |  | HanRun | HR911105A | C12074 | THT MagJack | 10/100BASE-T, integrated magnetics and LEDs | READY | Drop-in | HR911105A is cheap and widely stocked at JLC; alternatives are not guaranteed pin-compatible. | https://jlcpcb.com/partdetail/HanRun-HR911105A/C12074 | https://datasheet.lcsc.com/lcsc/1811141815_HANRUN-Zhongshan-HanRun-Elec-HR911105A_C12074.pdf
25 | UART Header 1x4 2.54mm | J3 | Connector_PinHeader_2.54mm:PinHeader_1x04_P2.54mm_Vertical | 1 |  | XFCN | PZ254V-11-04P | C2691448 | 1x4, 2.54 mm, vertical THT | 4-pin male UART header; 2.54 mm pitch; 3 A, 250 V connector rating | READY | Drop-in | Generic UART header intent confirmed. Clearly mark the pin order on the PCB (recommended: 3V3, TX, RX, GND) and verify mating-cable orientation. | https://jlcpcb.com/partdetail/XFCN-PZ254V_1104P/C2691448 | User-approved generic UART header
26 | Screw_Terminal_01x03 | J10,J11,J12,J13,J14 | TerminalBlock:TerminalBlock_MaiXu_MX126-5.0-03P_1x03_P5.00mm | 5 |  | MAX / MaiXu | MX126-5.0-03P-GN01-Cu-S-A | C5188435 | 3-pos THT, 5.00 mm | 10 A, 300 V, 14-26 AWG | READY | Drop-in | MaiXu 3-position, 5.00 mm screw terminals and the existing footprint are approved. | https://jlcpcb.com/partdetail/MAX-MX126_5_003P_GN01_Cu_S_A/C5188435
27 | G2RL-1-E | K10,K11,K12,K13,K14 | Relay_THT:Relay_SPDT_Omron_G2RL-1-E | 5 |  | Omron | G2RL-1-E-DC12 | C58243 | THT SPDT | 12 V coil; 16 A at 24 VDC resistive; 300 VDC max switching voltage | READY | Drop-in | Omron relay/contact selection is approved for this design. | https://jlcpcb.com/partdetail/Omron-G2RL_1_E_DC12/C58243 | https://omronfs.omron.com/en_US/ecb/products/pdf/en-g2rl.pdf
28 | MH1608-121Y | L1 | Library:IND_BOURNS_MH1608 | 1 |  | Bourns | MH1608-121Y | C2650949 | 0603 | 120 Ω @ 100 MHz, 2 A, ≤100 mΩ | READY | Drop-in | Primary meets 120 Ω/100 MHz and 2 A class. Verify DCR/current for the rail. | https://www.lcsc.com/product-detail/Ferrite-Beads_Bourns-MH1608-121Y_C2650949.html
29 | XFL4020-152MEC | L3 | Library:IND_XFL4020_COC-M | 1 |  | Coilcraft | XGL4020-152MEC |  | 4.0 x 4.0 mm | 1.5 µH, lower DCR, high-current; official drop-in successor to XFL4020 | READY | Drop-in / preferred upgrade | XGL4020 is the preferred lower-loss drop-in successor; XFL remains acceptable if stocked. | https://www.coilcraft.com/en-us/products/power/shielded-inductors/molded-inductor/xgl/xgl4020/ | XFL4020-152MEC
30 | 2.2k | R1,R2,R3,R4,R5 | Resistor_SMD:R_0603_1608Metric | 5 |  | UniOhm/Uniohm | 0603WAF2201T5E |  | 0603 | 2.2 kΩ, 1%, ≥0.1 W | READY | Drop-in | Commodity 1% 0603 resistor. | https://www.lcsc.com/search?q=0603WAF2201T5E
31 | 12.4k 1% - Ethernet external reference | R6 | Resistor_SMD:R_0402_1005Metric | 1 |  | UniOhm/Uniohm | 0402WGF1242TCE |  | 0402 | 12.4 kΩ, 1%, ≥0.063 W | READY | Drop-in | Use 1% or tighter for the W5500 external reference. | https://www.lcsc.com/search?q=0402WGF1242TCE
32 | 33 | R7,R8,R16,R17 | Resistor_SMD:R_0603_1608Metric | 4 |  | UniOhm/Uniohm | 0603WAF330JT5E |  | 0603 | 33 Ω, 1%, ≥0.1 W | READY | Drop-in | Commodity 1% 0603 resistor. | https://www.lcsc.com/search?q=0603WAF330JT5E
33 | 330 | R9,R15,R29 | Resistor_SMD:R_0603_1608Metric | 3 |  | UniOhm/Uniohm | 0603WAF3300T5E |  | 0603 | 330 Ω, 1%, ≥0.1 W | READY | Drop-in | Commodity 1% 0603 resistor. | https://www.lcsc.com/search?q=0603WAF3300T5E
34 | 100k | R10,R11,R12,R13,R14 | Resistor_SMD:R_0603_1608Metric | 5 |  | UniOhm/Uniohm | 0603WAF1003T5E |  | 0603 | 100 kΩ, 1%, ≥0.1 W | READY | Drop-in | Commodity 1% 0603 resistor. | https://www.lcsc.com/search?q=0603WAF1003T5E
35 | 49.9 1% | R18,R19,R21,R22 | Resistor_SMD:R_0201_0603Metric | 4 |  | UniOhm/Uniohm | 0201WMF499JTCE |  | 0201 | 49.9 Ω, 1%, ≥0.05 W | READY | Drop-in | Use 1% 49.9 Ω; 0201 assembly requires JLC Standard PCBA and careful DFM. | https://www.lcsc.com/search?q=0201WMF499JTCE
36 | 10 1% | R20 | Resistor_SMD:R_0201_0603Metric | 1 |  | UniOhm/Uniohm | 0201WMF100JTCE |  | 0201 | 10 Ω, 1%, ≥0.05 W | READY | Drop-in | Use 1% 10 Ω; 0201 assembly requires careful DFM. | https://www.lcsc.com/search?q=0201WMF100JTCE
37 | 0 | R23 | Resistor_SMD:R_0402_1005Metric | 1 |  | UniOhm/Uniohm | 0402WGJ0000TCE |  | 0402 | 0 Ω jumper, ≥0.063 W | READY | Drop-in | Commodity 0 Ω jumper. | https://www.lcsc.com/search?q=0402WGJ0000TCE
38 | 1M | R24 | Resistor_SMD:R_0402_1005Metric | 1 |  | UniOhm/Uniohm | 0402WGF1004TCE |  | 0402 | 1 MΩ, 1%, ≥0.063 W | READY | Drop-in | Commodity 1% resistor. | https://www.lcsc.com/search?q=0402WGF1004TCE
39 | 10k | R25 | Resistor_SMD:R_0603_1608Metric | 1 |  | UniOhm/Uniohm | 0603WAF1002T5E |  | 0603 | 10 kΩ, 1%, ≥0.1 W | READY | Drop-in | Commodity 1% resistor. | https://www.lcsc.com/search?q=0603WAF1002T5E
40 | 10kΩ | R26 | Resistor_SMD:R_0402_1005Metric | 1 |  | UniOhm/Uniohm | 0402WGF1002TCE |  | 0402 | 10 kΩ, 1%, ≥0.063 W | READY | Drop-in | Commodity 1% resistor. | https://www.lcsc.com/search?q=0402WGF1002TCE
41 | 100kΩ | R28 | Resistor_SMD:R_0603_1608Metric | 1 |  | UniOhm/Uniohm | 0603WAF1003T5E |  | 0603 | 100 kΩ, 1%, ≥0.1 W | READY | Drop-in | Commodity 1% resistor. | https://www.lcsc.com/search?q=0603WAF1003T5E
42 | ENABLE | SW5 | Button_Switch_THT:SW_PUSH_6mm_H5mm | 1 |  | BZCN | TSD001A05018A | C2888545 | 6 x 6 mm, 4-pin THT tactile switch | SPST-NO, 5.0 mm height, 1.8 N, 12 V, 50 mA | READY | Drop-in | Matches KiCad Button_Switch_THT:SW_PUSH_6mm_H5mm intent. Through-hole placement requires wave/selective soldering or hand assembly. | https://jlcpcb.com/partdetail/BZCN-TSD001A05018A/C2888545 | User-approved generic 6 mm 4-pin pushbutton
43 | RESET | SW6 | Button_Switch_THT:SW_PUSH_6mm_H5mm | 1 |  | BZCN | TSD001A05018A | C2888545 | 6 x 6 mm, 4-pin THT tactile switch | SPST-NO, 5.0 mm height, 1.8 N, 12 V, 50 mA | READY | Drop-in | Matches KiCad Button_Switch_THT:SW_PUSH_6mm_H5mm intent. Through-hole placement requires wave/selective soldering or hand assembly. | https://jlcpcb.com/partdetail/BZCN-TSD001A05018A/C2888545 | User-approved generic 6 mm 4-pin pushbutton
44 | ESP32-WROOM-32UE | U1 | RF_Module:ESP32-WROOM-32UE | 1 |  | Espressif | ESP32-WROOM-32UE-N8 | C701345 | ESP32-WROOM-32UE module | 8 MB flash, external antenna connector | READY | Drop-in | N8 is a practical default. N4 is cheaper; N16 gives more OTA/filesystem margin. | https://jlcpcb.com/partdetail/EspressifSystems-ESP32_WROOM_32UE_N8/C701345 | https://www.espressif.com/sites/default/files/documentation/esp32-wroom-32e_esp32-wroom-32ue_datasheet_en.pdf
45 | ULN2803A | U2 | Package_SO:SOIC-18W_7.5x11.6mm_P1.27mm | 1 |  | Mixic | ULN2803A | C107219 | SOP-18 300 mil | 8-channel Darlington sink array, 50 V, 500 mA/channel class | READY | Drop-in | Cheap second-source arrays are suitable electrically for 12 V relay coils, but qualify vendor quality if production reliability is critical. | https://jlcpcb.com/partdetail/Mixic-ULN2803A/C107219 | http://www.ti.com/lit/ds/symlink/uln2803a.pdf
46 | W5500 | U3 | Package_QFP:LQFP-48_7x7mm_P0.5mm | 1 |  | WIZnet | W5500 | C32843 | LQFP-48 7x7 | Hardwired TCP/IP Ethernet controller, 3.3 V, integrated 10/100 PHY | READY | Drop-in | W5500 has no true second-source pin-compatible alternate. Keep authorized-channel W5500 as the AVL; other Ethernet controllers require redesign. | https://jlcpcb.com/partdetail/WIZnet-W5500/C32843 | https://docs.wiznet.io/img/products/w5500/W5500_ds_v110e.pdf
47 | 3A 32V | U4 | Fuse:Fuse_1206_3216Metric | 1 |  | Bel Fuse | 0685F3000-01 |  | 1206 | 3 A, fast-acting C1F series; verify 63 V DC rating | VERIFY | Drop-in | Assumed input fuse. Verify exact Bel C1F 3 voltage/interrupt rating and whether fast-acting behavior coordinates with input surge/inrush. | https://www.digikey.com/en/products/result?keywords=0685F3000-01 | C1F 3
48 | TPS630701RNMR | U5 | Library:RNM0015A | 1 |  | Texas Instruments | TPS630701RNMR | C2876599 | VQFN-HR-15, 3x2.5 mm | Fixed 5 V buck-boost, 2-16 V input, 2 A output class | READY | Drop-in | Exact fixed-5 V part is well stocked. Do not substitute adjustable variants without reviewing the feedback/VSEL network. | https://jlcpcb.com/partdetail/TexasInstruments-TPS630701RNMR/C2876599 | https://www.ti.com/lit/gpn/tps63070
49 | TVS1400DRVR | U7 | Library:DRV0006A_NV | 1 |  | Texas Instruments | TVS1400DRVR | C1975229 | WSON-6 2x2 | 14 V standoff flat-clamp TVS, 19.3 V max clamp at specified surge | READY | Drop-in | TVS1400DRVR approved for this design and retained in the existing WSON-6 footprint. Validate the complete surge response on the first assembled prototypes. | https://jlcpcb.com/partdetail/TexasInstruments-TVS1400DRVR/C1975229 | https://www.ti.com/lit/gpn/tvs1400
50 | TLV1117LV33DCYR | U9,U10 | Library:TLV1117-33IDCYR | 2 |  | Texas Instruments | TLV1117LV33DCYR | C15578 | SOT-223-4 | 3.3 V fixed, 1 A, VIN 2-5.5 V, ceramic stable | READY | Drop-in | Exact TI part is preferred; avoid generic 1117 substitutions unless input range, dropout, stability, thermal dissipation and pinout are rechecked. | https://www.lcsc.com/product-detail/Low-Dropout-Regulators-LDO_TI_TLV1117LV33DCYR_TLV1117LV33DCYR_C15578.html | https://www.ti.com/lit/gpn/tlv1117lv
51 | ABM3C-25.000MHZ-D4Y-T | Y2 | Library:CRYSTAL_ABM3C_ABR-M | 1 |  | HCI | XC53M4-25.000-F18NJDTL | C2962760 | 5032 4-pad | 25 MHz, 18 pF load, 50 Ω class, -40 to 85°C | READY | Drop-in | Selected 25 MHz, 18 pF, 5032 four-pad crystal approved for production. | https://jlcpcb.com/partdetail/HCI-XC53M4_25000_F18NJDTL/C2962760 | https://abracon.com/Resonators/ABM3C.pdf

Sheet: JLC Import Draft
Comment | Designator | Footprint | LCSC Part # | Manufacturer Part # | Qty | DNP | Release Status
10uF | C1,C8,C26,C27 | Capacitor_SMD:C_0805_2012Metric | C1713 | CL21A106KOQNNNE | 4 |  | READY
10uF | C2,C28,C29 | Capacitor_SMD:C_0603_1608Metric | C86275 | GRM188R61C106KAALD | 3 |  | VERIFY
0.1uF | C3,C4 | Capacitor_SMD:C_0603_1608Metric | C14663 | CC0603KRX7R9BB104 | 2 |  | READY
4.7uF - Eth Reference Cap | C5 | Capacitor_SMD:C_0201_0603Metric |  | GRM033R60J475ME05D | 1 |  | VERIFY
22nF | C6 | Capacitor_SMD:C_0201_0603Metric |  | GRM033R71H223KA12D | 1 |  | READY
0.1uF | C7 | Capacitor_SMD:C_0201_0603Metric | C307379 | CL03A104KA3NNNC | 1 |  | READY
100uF - Electrolytic | C9 | Capacitor_SMD:C_Elec_6.3x7.7 |  | EEE-FK1E101P | 1 |  | VERIFY
100nF - Ceramic | C10 | Capacitor_SMD:C_0603_1608Metric | C14663 | CC0603KRX7R9BB104 | 1 |  | READY
0.1uF | C11,C12,C13,C14,C15,C16 | Capacitor_SMD:C_0402_1005Metric | C1525 | CL05B104KO5NNNC | 6 |  | READY
6.8nF | C17,C19 | Capacitor_SMD:C_0201_0603Metric |  | GRM033R71H682KA12D | 2 |  | READY
10uF / 16V | C18 | Capacitor_SMD:C_0805_2012Metric |  | CL21A106KOQNNNE | 1 |  | READY
10nF | C20,C23 | Capacitor_SMD:C_0201_0603Metric |  | GRM033R71H103KA12D | 2 |  | READY
18pF | C21,C22 | Capacitor_SMD:C_0201_0603Metric |  | GRM0335C1H180JA01D | 2 |  | READY
1uF - Ceramic | C24 | Capacitor_SMD:C_0805_2012Metric | C95840 | CL21A105KAFNNNE | 1 |  | READY
100nF | C25 | Capacitor_SMD:C_0201_0603Metric | C307379 | CL03A104KA3NNNC | 1 |  | READY
22uF | C30,C31 | Capacitor_SMD:C_0805_2012Metric |  | GRM21BR61A226ME44K | 2 |  | VERIFY
1uF | C32,C33,C34,C35 | Capacitor_SMD:C_0805_2012Metric | C95840 | CL21A105KAFNNNE | 4 |  | READY
1uF | C36,C37 | Capacitor_SMD:C_0402_1005Metric | C29266 | CL05A105KO5NNNC | 2 |  | READY
LED Orange 0805 | D1,D2,D3,D4,D5 | LED_SMD:LED_0805_2012Metric | C284931 | LTST-C170KFKT | 5 |  | READY
LED Red Low-Power 0201 | D6 | LED_SMD:LED_0201_0603Metric | C20617267 | LTST-FC03ED-5A | 1 |  | READY
5A 63V Slow-Blow Fuse | F1,F2,F5 | Fuse:Fuse_1206_3216Metric | C553937 | S1206-SD-5.0A | 3 |  | READY
5A 63V Slow-Blow Fuse | F3,F4 | Fuse:Fuse_1206_3216Metric | C553937 | S1206-SD-5.0A | 2 |  | READY
12 | J1 | Connector_BarrelJack:BarrelJack_CUI_PJ-102AH_Horizontal | C9900001188 | PJ-102AH | 1 |  | VERIFY
RJ45_Hanrun_HR911105A_Horizontal | J2 | Connector_RJ:RJ45_Hanrun_HR911105A_Horizontal | C12074 | HR911105A | 1 |  | READY
UART Header 1x4 2.54mm | J3 | Connector_PinHeader_2.54mm:PinHeader_1x04_P2.54mm_Vertical | C2691448 | PZ254V-11-04P | 1 |  | READY
Screw_Terminal_01x03 | J10,J11,J12,J13,J14 | TerminalBlock:TerminalBlock_MaiXu_MX126-5.0-03P_1x03_P5.00mm | C5188435 | MX126-5.0-03P-GN01-Cu-S-A | 5 |  | READY
G2RL-1-E | K10,K11,K12,K13,K14 | Relay_THT:Relay_SPDT_Omron_G2RL-1-E | C58243 | G2RL-1-E-DC12 | 5 |  | READY
MH1608-121Y | L1 | Library:IND_BOURNS_MH1608 | C2650949 | MH1608-121Y | 1 |  | READY
XFL4020-152MEC | L3 | Library:IND_XFL4020_COC-M |  | XGL4020-152MEC | 1 |  | READY
2.2k | R1,R2,R3,R4,R5 | Resistor_SMD:R_0603_1608Metric |  | 0603WAF2201T5E | 5 |  | READY
12.4k 1% - Ethernet external reference | R6 | Resistor_SMD:R_0402_1005Metric |  | 0402WGF1242TCE | 1 |  | READY
33 | R7,R8,R16,R17 | Resistor_SMD:R_0603_1608Metric |  | 0603WAF330JT5E | 4 |  | READY
330 | R9,R15,R29 | Resistor_SMD:R_0603_1608Metric |  | 0603WAF3300T5E | 3 |  | READY
100k | R10,R11,R12,R13,R14 | Resistor_SMD:R_0603_1608Metric |  | 0603WAF1003T5E | 5 |  | READY
49.9 1% | R18,R19,R21,R22 | Resistor_SMD:R_0201_0603Metric |  | 0201WMF499JTCE | 4 |  | READY
10 1% | R20 | Resistor_SMD:R_0201_0603Metric |  | 0201WMF100JTCE | 1 |  | READY
0 | R23 | Resistor_SMD:R_0402_1005Metric |  | 0402WGJ0000TCE | 1 |  | READY
1M | R24 | Resistor_SMD:R_0402_1005Metric |  | 0402WGF1004TCE | 1 |  | READY
10k | R25 | Resistor_SMD:R_0603_1608Metric |  | 0603WAF1002T5E | 1 |  | READY
10kΩ | R26 | Resistor_SMD:R_0402_1005Metric |  | 0402WGF1002TCE | 1 |  | READY
100kΩ | R28 | Resistor_SMD:R_0603_1608Metric |  | 0603WAF1003T5E | 1 |  | READY
ENABLE | SW5 | Button_Switch_THT:SW_PUSH_6mm_H5mm | C2888545 | TSD001A05018A | 1 |  | READY
RESET | SW6 | Button_Switch_THT:SW_PUSH_6mm_H5mm | C2888545 | TSD001A05018A | 1 |  | READY
ESP32-WROOM-32UE | U1 | RF_Module:ESP32-WROOM-32UE | C701345 | ESP32-WROOM-32UE-N8 | 1 |  | READY
ULN2803A | U2 | Package_SO:SOIC-18W_7.5x11.6mm_P1.27mm | C107219 | ULN2803A | 1 |  | READY
W5500 | U3 | Package_QFP:LQFP-48_7x7mm_P0.5mm | C32843 | W5500 | 1 |  | READY
3A 32V | U4 | Fuse:Fuse_1206_3216Metric |  | 0685F3000-01 | 1 |  | VERIFY
TPS630701RNMR | U5 | Library:RNM0015A | C2876599 | TPS630701RNMR | 1 |  | READY
TVS1400DRVR | U7 | Library:DRV0006A_NV | C1975229 | TVS1400DRVR | 1 |  | READY
TLV1117LV33DCYR | U9,U10 | Library:TLV1117-33IDCYR | C15578 | TLV1117LV33DCYR | 2 |  | READY
ABM3C-25.000MHZ-D4Y-T | Y2 | Library:CRYSTAL_ABM3C_ABR-M | C2962760 | XC53M4-25.000-F18NJDTL | 1 |  | READY

Sheet: Release Holds
Priority | Designator | Status | Issue / Note | Required Resolution | Selected Primary | Footprint | Source
P1 | C2,C28,C29 | VERIFY | Package split resolved. 10 µF in 0603 is strongly DC-bias dependent; confirm effective capacitance at each actual rail voltage. | Engineering/procurement verification before order. | GRM188R61C106KAALD | Capacitor_SMD:C_0603_1608Metric | https://jlcpcb.com/partdetail/MurataElectronics-GRM188R61C106KAALD/C86275
P1 | C5 | VERIFY | 4.7 µF in 0201 is specialty and strongly DC-bias dependent. Confirm the W5500 reference node voltage and effective capacitance; 0402/0603 is safer if layout permits. Check effective capacitance under DC bias; 0201 assembly is less forgiving. | Engineering/procurement verification before order. | GRM033R60J475ME05D | Capacitor_SMD:C_0201_0603Metric | https://www.digikey.com/en/products/detail/murata-electronics/GRM033R60J475ME05D/16033659
P1 | C9 | VERIFY | Assumed 12 V input bulk capacitor; use ≥25 V and verify ESR/ripple-current and exact 6.3 x 7.7 mm land pattern. | Engineering/procurement verification before order. | EEE-FK1E101P | Capacitor_SMD:C_Elec_6.3x7.7 | https://www.digikey.com/en/products/result?keywords=EEE-FK1E101P
P1 | C30,C31 | VERIFY | Primary MPN corrected to a true 22 µF 0805 part. Verify 10 V rating and effective capacitance at the actual rail voltage. | Engineering/procurement verification before order. | GRM21BR61A226ME44K | Capacitor_SMD:C_0805_2012Metric | https://www.digikey.com/en/products/detail/murata-electronics/GRM21BR61A226ME44K/26223516
P1 | J1 | VERIFY | Exact jack can be sourced, but JLC availability may require pre-order/consignment. Confirm adapter plug size, polarity, current, and switched-pin use. | Engineering/procurement verification before order. | PJ-102AH | Connector_BarrelJack:BarrelJack_CUI_PJ-102AH_Horizontal | https://jlcpcb.com/partdetail/CUIDevices-PJ102AH/C9900001188
P1 | U4 | VERIFY | Assumed input fuse. Verify exact Bel C1F 3 voltage/interrupt rating and whether fast-acting behavior coordinates with input surge/inrush. | Engineering/procurement verification before order. | 0685F3000-01 | Fuse:Fuse_1206_3216Metric | https://www.digikey.com/en/products/result?keywords=0685F3000-01

Sheet: Source BOM
Reference | Value | Datasheet | Footprint | Qty | DNP
C1,C8,C26,C27 | 10uF | CL21A106KOQNNNE | Capacitor_SMD:C_0805_2012Metric | 4
C2,C28,C29 | 10uF | CL21A106KOQNNNE | Capacitor_SMD:C_0603_1608Metric | 3
C3,C4 | 0.1uF |  | Capacitor_SMD:C_0603_1608Metric | 2
C5 | 4.7uF - Eth Reference Cap |  | Capacitor_SMD:C_0201_0603Metric | 1
C6 | 22nF |  | Capacitor_SMD:C_0201_0603Metric | 1
C7 | 0.1uF |  | Capacitor_SMD:C_0201_0603Metric | 1
C9 | 100uF - Electrolytic |  | Capacitor_SMD:C_Elec_6.3x7.7 | 1
C10 | 100nF - Ceramic |  | Capacitor_SMD:C_0603_1608Metric | 1
C11,C12,C13,C14,C15,C16 | 0.1uF |  | Capacitor_SMD:C_0402_1005Metric | 6
C17,C19 | 6.8nF |  | Capacitor_SMD:C_0201_0603Metric | 2
C18 | 10uF / 16V |  | Capacitor_SMD:C_0805_2012Metric | 1
C20,C23 | 10nF |  | Capacitor_SMD:C_0201_0603Metric | 2
C21,C22 | 18pF |  | Capacitor_SMD:C_0201_0603Metric | 2
C24 | 1uF - Ceramic |  | Capacitor_SMD:C_0805_2012Metric | 1
C25 | 100nF |  | Capacitor_SMD:C_0201_0603Metric | 1
C30,C31 | 22uF | CL21A106KOQNNNE | Capacitor_SMD:C_0805_2012Metric | 2
C32,C33,C34,C35 | 1uF |  | Capacitor_SMD:C_0805_2012Metric | 4
C36,C37 | 1uF |  | Capacitor_SMD:C_0402_1005Metric | 2
D1,D2,D3,D4,D5 | LED Orange 0805 | https://www.lcsc.com/product-detail/C284931.html | LED_SMD:LED_0805_2012Metric | 5
D6 | LED Red Low-Power 0201 | https://jlcpcb.com/partdetail/LiteOn-LTST_FC03ED5A/C20617267 | LED_SMD:LED_0201_0603Metric | 1
F1,F2,F5 | S1206-SD-5.0A | https://jlcpcb.com/partdetail/SART_Nanjing_Sart_Tech-S1206_SD_50A/C553937 | Fuse:Fuse_1206_3216Metric | 3
F3,F4 | S1206-SD-5.0A | https://jlcpcb.com/partdetail/SART_Nanjing_Sart_Tech-S1206_SD_50A/C553937 | Fuse:Fuse_1206_3216Metric | 2
J1 | 12 |  | Connector_BarrelJack:BarrelJack_CUI_PJ-102AH_Horizontal | 1
J2 | RJ45_Hanrun_HR911105A_Horizontal | https://datasheet.lcsc.com/lcsc/1811141815_HANRUN-Zhongshan-HanRun-Elec-HR911105A_C12074.pdf | Connector_RJ:RJ45_Hanrun_HR911105A_Horizontal | 1
J3 | B4B-PH-SM4-TB | B4B-PH-SM4-TB | Connector_PinHeader_2.54mm:PinHeader_1x04_P2.54mm_Vertical | 1
J10,J11,J12,J13,J14 | Screw_Terminal_01x03 |  | TerminalBlock:TerminalBlock_MaiXu_MX126-5.0-03P_1x03_P5.00mm | 5
K10,K11,K12,K13,K14 | G2RL-1-E | https://omronfs.omron.com/en_US/ecb/products/pdf/en-g2rl.pdf | Relay_THT:Relay_SPDT_Omron_G2RL-1-E | 5
L1 | MH1608-121Y |  | Library:IND_BOURNS_MH1608 | 1
L3 | XFL4020-152MEC | XFL4020-152MEC | Library:IND_XFL4020_COC-M | 1
R1,R2,R3,R4,R5 | 2.2k |  | Resistor_SMD:R_0603_1608Metric | 5
R6 | 12.4k 1% - Ethernet external reference |  | Resistor_SMD:R_0402_1005Metric | 1
R7,R8,R16,R17 | 33 |  | Resistor_SMD:R_0603_1608Metric | 4
R9,R15,R29 | 330 |  | Resistor_SMD:R_0603_1608Metric | 3
R10,R11,R12,R13,R14 | 100k |  | Resistor_SMD:R_0603_1608Metric | 5
R18,R19,R21,R22 | 49.9 1% |  | Resistor_SMD:R_0201_0603Metric | 4
R20 | 10 1% |  | Resistor_SMD:R_0201_0603Metric | 1
R23 | 0 |  | Resistor_SMD:R_0402_1005Metric | 1
R24 | 1M |  | Resistor_SMD:R_0402_1005Metric | 1
R25 | 10k |  | Resistor_SMD:R_0603_1608Metric | 1
R26 | 10kΩ |  | Resistor_SMD:R_0402_1005Metric | 1
R28 | 100kΩ |  | Resistor_SMD:R_0603_1608Metric | 1
SW5 | ENABLE | PTS815 SJM 250 SMTR LFS | Button_Switch_THT:SW_PUSH_6mm_H5mm | 1
SW6 | RESET | PTS815 SJM 250 SMTR LFS | Button_Switch_THT:SW_PUSH_6mm_H5mm | 1
U1 | ESP32-WROOM-32UE | https://www.espressif.com/sites/default/files/documentation/esp32-wroom-32e_esp32-wroom-32ue_datasheet_en.pdf | RF_Module:ESP32-WROOM-32UE | 1
U2 | ULN2803A | http://www.ti.com/lit/ds/symlink/uln2803a.pdf | Package_SO:SOIC-18W_7.5x11.6mm_P1.27mm | 1
U3 | W5500 | https://docs.wiznet.io/img/products/w5500/W5500_ds_v110e.pdf | Package_QFP:LQFP-48_7x7mm_P0.5mm | 1
U4 | 3A 32V | C1F 3 | Fuse:Fuse_1206_3216Metric | 1
U5 | TPS630701RNMR | https://www.ti.com/lit/gpn/tps63070 | Library:RNM0015A | 1
U7 | TVS1400DRVR | https://www.ti.com/lit/gpn/tvs1400 | Library:DRV0006A_NV | 1
U9,U10 | TLV1117LV33DCYR | https://www.ti.com/lit/gpn/tlv1117lv | Library:TLV1117-33IDCYR | 2
Y2 | ABM3C-25.000MHZ-D4Y-T | https://abracon.com/Resonators/ABM3C.pdf | Library:CRYSTAL_ABM3C_ABR-M | 1
