StickOnAStick/48VRelay_essential/RelatBoard/48VRelay/48VERelay/_restore_backup_2026-08-07T21-41-39-209/48VERelay.kicad_pcb

## KiCad design RelatBoard/48VRelay/48VERelay/_restore_backup_2026-08-07T21-41-39-209/48VERelay.kicad_pcb (2026-08-09)

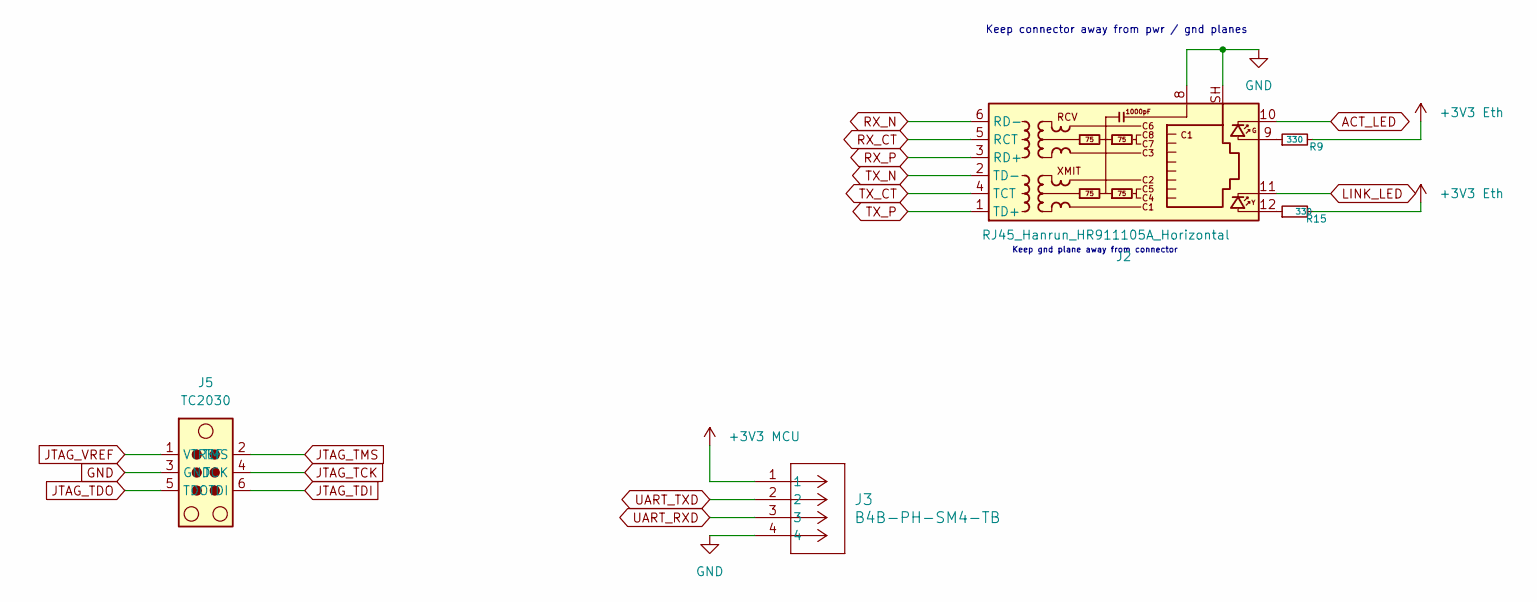
[picture p1: schematic Connectors.kicad_sch]

Parts:
J2: RJ45_Hanrun_HR911105A_Horizontal
J3: B4B-PH-SM4-TB; PinHeader_1x04_P2.54mm_Vertical
J5: TC2030; Tag-Connect_TC2030-IDC-NL_2x03_P1.27mm_Vertical
R9, R15: 330; R_0603_1608Metric

Connections:
3V3 MCU: J3.1, J5.1 (VTREF); also elsewhere on the board
+3V3 Eth: R9.2, R15.2; also elsewhere on the board
ACT_LED: J2.10; also elsewhere on the board
GND: J2.8, J2.SH, J3.4, J5.3 (GND); also elsewhere on the board
JTAG_TCK: J5.4 (TCK); also elsewhere on the board
JTAG_TDI: J5.6 (TDI); also elsewhere on the board
JTAG_TDO: J5.5 (TDO); also elsewhere on the board
JTAG_TMS: J5.2 (TMS); also elsewhere on the board
LINK_LED: J2.11; also elsewhere on the board
unnamed: J2.9, R9.1
unnamed: J2.12, R15.1
RX_CT: J2.5 (RCT); also elsewhere on the board
RX_N: J2.6 (RD-); also elsewhere on the board
RX_P: J2.3 (RD+); also elsewhere on the board
TX_CT: J2.4 (TCT); also elsewhere on the board
TX_N: J2.2 (TD-); also elsewhere on the board
TX_P: J2.1 (TD+); also elsewhere on the board
UART_RXD: J3.3; also elsewhere on the board
UART_TXD: J3.2; also elsewhere on the board

Notes on the sheet:
Keep gnd plane away from connector
Keep connector away from pwr / gnd planes

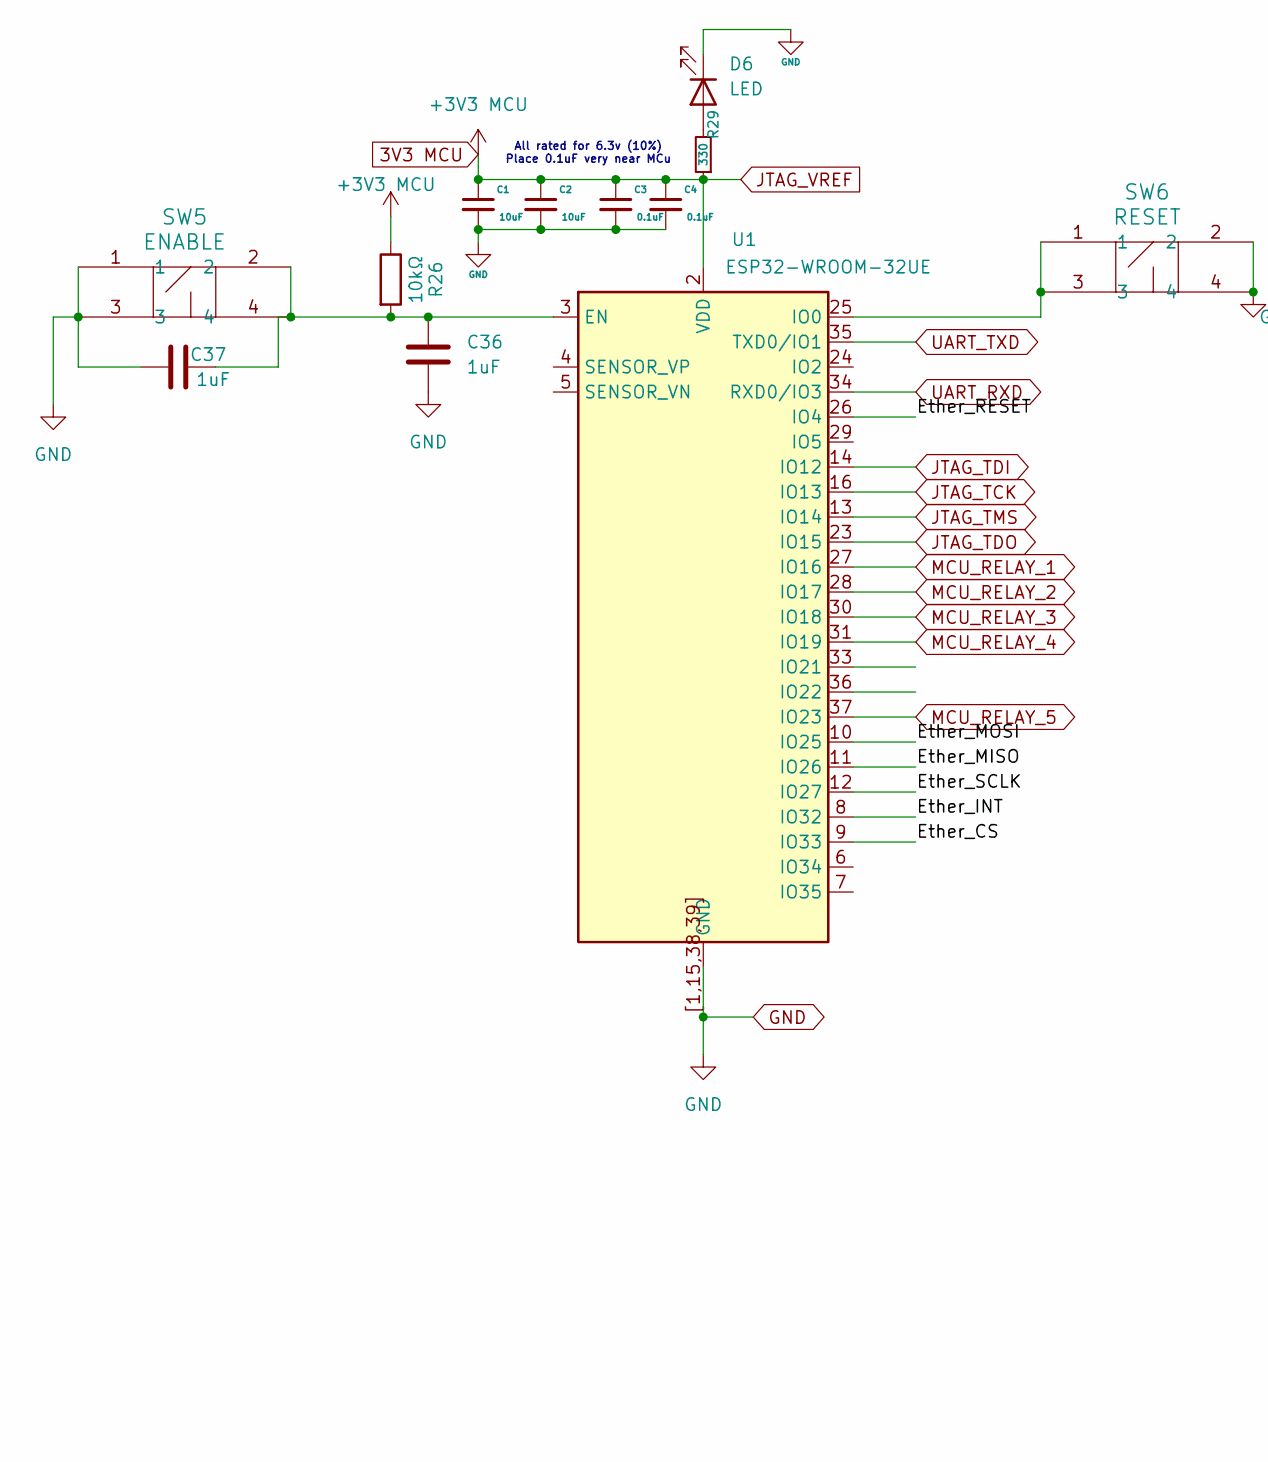
[picture p2: schematic MCU.kicad_sch, part in row 1, column 1]

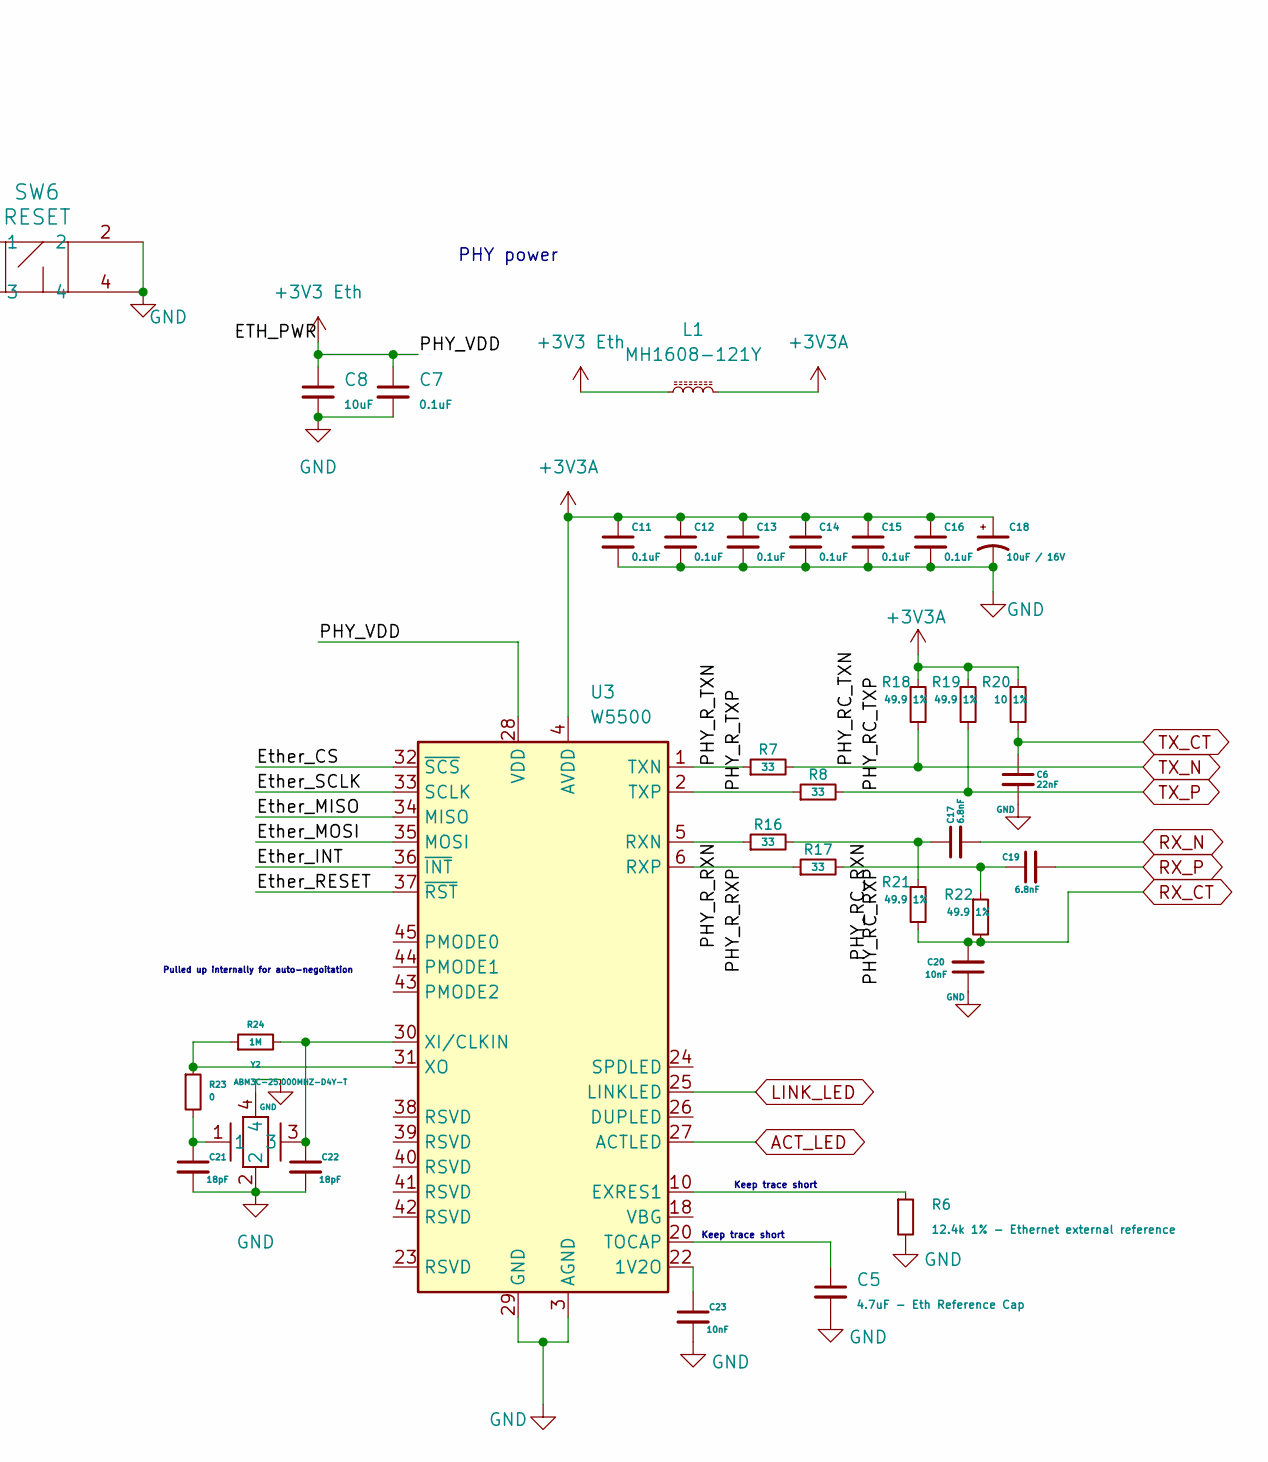
[picture p3: schematic MCU.kicad_sch, part in row 1, column 2]

Parts:
C1, C8: 10uF; C_0805_2012Metric
C2: 10uF; C_0603_1608Metric
C3, C4: 0.1uF; C_0603_1608Metric
C5: 4.7uF - Eth Reference Cap; C_0201_0603Metric
C6: 22nF; C_0201_0603Metric
C7: 0.1uF; C_0201_0603Metric
C11, C12, C13, C14, C15, C16: 0.1uF; C_0402_1005Metric
C17, C19: 6.8nF; C_0201_0603Metric
C18: 10uF / 16V; C_0805_2012Metric
C20, C23: 10nF; C_0201_0603Metric
C21, C22: 18pF; C_0201_0603Metric
C36, C37: 1uF; C_0402_1005Metric
D6: LED; LED_0603_1608Metric
L1: MH1608-121Y; IND_BOURNS_MH1608
R6: 12.4k 1% - Ethernet external reference; R_0402_1005Metric
R7, R8, R16, R17: 33; R_0603_1608Metric
R18, R19, R21, R22: 49.9 1%; R_0201_0603Metric
R20: 10 1%; R_0201_0603Metric
R23: 0; R_0402_1005Metric
R24: 1M; R_0402_1005Metric
R26: 10kΩ; R_0402_1005Metric
R29: 330; R_0603_1608Metric
SW5: ENABLE; SW_PUSH_6mm_H5mm
SW6: RESET; SW_PUSH_6mm_H5mm
U1: ESP32-WROOM-32UE
U3: W5500; LQFP-48_7x7mm_P0.5mm
Y2: ABM3C-25.000MHZ-D4Y-T; CRYSTAL_ABM3C_ABR-M

Connections:
3V3 MCU: C1.1, C2.1, C3.1, C4.1, R26.1, R29.1, U1.2 (VDD); also elsewhere on the board
+3V3 Eth: C7.1, C8.1, L1.1, U3.28 (VDD); also elsewhere on the board
+3V3A: C11.1, C12.1, C13.1, C14.1, C15.1, C16.1, C18.1, L1.2, R18.1, R19.1, R20.1, U3.4 (AVDD), U3.8 (AVDD), U3.11 (AVDD), U3.15 (AVDD), U3.17 (AVDD), U3.21 (AVDD); also elsewhere on the board
/MCU/Ether_CS: U1.9 (IO33), U3.32 (~SCS)
/MCU/Ether_INT: U1.8 (IO32), U3.36 (~INT)
/MCU/Ether_MISO: U1.11 (IO26), U3.34 (MISO)
/MCU/Ether_MOSI: U1.10 (IO25), U3.35 (MOSI)
/MCU/Ether_RESET: U1.26 (IO4), U3.37 (~RST)
/MCU/Ether_SCLK: U1.12 (IO27), U3.33 (SCLK)
/MCU/PHY_RC_RXN: C17.1, R16.2, R21.1
/MCU/PHY_RC_RXP: C19.1, R17.2, R22.1
/MCU/PHY_R_RXN: R16.1, U3.5 (RXN)
/MCU/PHY_R_RXP: R17.1, U3.6 (RXP)
/MCU/PHY_R_TXN: R7.1, U3.1 (TXN)
/MCU/PHY_R_TXP: R8.1, U3.2 (TXP)
ACT_LED: U3.27 (ACTLED); also elsewhere on the board
GND: C1.2, C2.2, C3.2, C4.2, C5.2, C6.2, C7.2, C8.2, C11.2, C12.2, C13.2, C14.2, C15.2, C16.2, C18.2, C20.1, C21.2, C22.2, C23.2, C36.2, C37.2, D6.1 (K), R6.2, SW5.1, SW5.3, SW6.2, SW6.4, U1.1 (GND), U1.15 (GND), U1.38 (GND), U1.39 (GND), U1.[1,15,38,39] (GND), U3.3 (AGND), U3.9 (AGND), U3.14 (AGND), U3.16 (AGND), U3.19 (AGND), U3.29 (GND), U3.48 (AGND), Y2.2, Y2.4; also elsewhere on the board
JTAG_TCK: U1.16 (IO13); also elsewhere on the board
JTAG_TDI: U1.14 (IO12); also elsewhere on the board
JTAG_TDO: U1.23 (IO15); also elsewhere on the board
JTAG_TMS: U1.13 (IO14); also elsewhere on the board
LINK_LED: U3.25 (LINKLED); also elsewhere on the board
MCU_RELAY_1: U1.27 (IO16); also elsewhere on the board
MCU_RELAY_2: U1.28 (IO17); also elsewhere on the board
MCU_RELAY_3: U1.30 (IO18); also elsewhere on the board
MCU_RELAY_4: U1.31 (IO19); also elsewhere on the board
MCU_RELAY_5: U1.37 (IO23); also elsewhere on the board
unnamed: C21.1, R23.2, Y2.1
unnamed: D6.2 (A), R29.2
unnamed: C36.1, C37.1, R26.2, SW5.2, SW5.4, U1.3 (EN)
unnamed: SW6.1, SW6.3, U1.25 (IO0)
unnamed: C23.1, U3.22 (1V2O)
unnamed: R6.1, U3.10 (EXRES1)
unnamed: C5.1, U3.20 (TOCAP)
unnamed: C22.1, R24.2, U3.30 (XI/CLKIN), Y2.3
unnamed: R23.1, R24.1, U3.31 (XO)
RX_CT: C20.2, R21.2, R22.2; also elsewhere on the board
RX_N: C17.2; also elsewhere on the board
RX_P: C19.2; also elsewhere on the board
TX_CT: C6.1, R20.2; also elsewhere on the board
TX_N: R7.2, R18.2; also elsewhere on the board
TX_P: R8.2, R19.2; also elsewhere on the board
UART_RXD: U1.34 (RXD0/IO3); also elsewhere on the board
UART_TXD: U1.35 (TXD0/IO1); also elsewhere on the board

Notes on the sheet:
Keep trace short
PHY power
All rated for 6.3v (10%) Place 0.1uF very near MCu
Pulled up internally for auto-negoitation

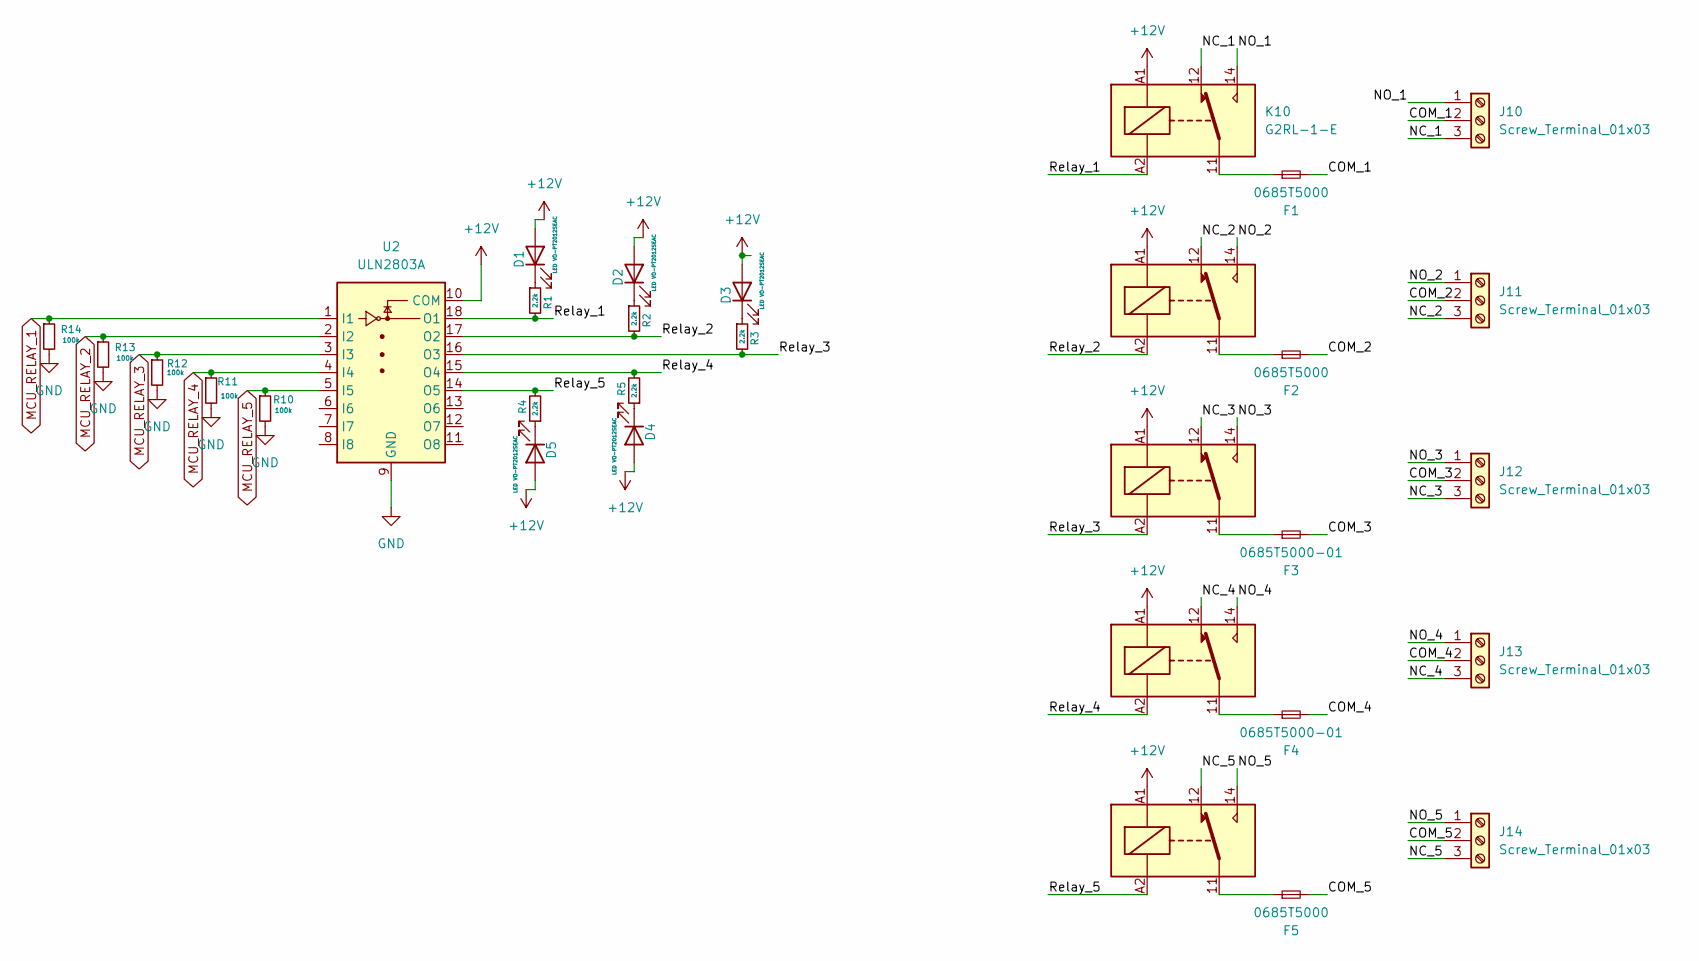
[picture p4: schematic Outputs.kicad_sch]

Parts:
D1, D2, D3, D4, D5: LED VO-PT2012SEAC; LED_0805_2012Metric
F1, F2, F5: 0685T5000; Fuse_1206_3216Metric
F3, F4: 0685T5000-01; Fuse_1206_3216Metric
J10, J11, J12, J13, J14: Screw_Terminal_01x03; TerminalBlock_MaiXu_MX126-5.0-03P_1x03_P5.00mm
K10, K11, K12, K13, K14: G2RL-1-E; Relay_SPDT_Omron_G2RL-1-E
R1, R2, R3, R4, R5: 2.2k; R_0603_1608Metric
R10, R11, R12, R13, R14: 100k; R_0603_1608Metric
U2: ULN2803A; SOIC-18W_7.5x11.6mm_P1.27mm

Connections:
+12V: D1.2 (A), D2.2 (A), D3.2 (A), D4.2 (A), D5.2 (A), K10.A1, K11.A1, K12.A1, K13.A1, K14.A1, U2.10 (COM); also elsewhere on the board
/Outputs/COM_1: F1.2, J10.2
/Outputs/COM_2: F2.2, J11.2
/Outputs/COM_3: F3.2, J12.2
/Outputs/COM_4: F4.2, J13.2
/Outputs/COM_5: F5.2, J14.2
/Outputs/NC_1: J10.3, K10.12
/Outputs/NC_2: J11.3, K11.12
/Outputs/NC_3: J12.3, K12.12
/Outputs/NC_4: J13.3, K13.12
/Outputs/NC_5: J14.3, K14.12
/Outputs/NO_1: J10.1, K10.14
/Outputs/NO_2: J11.1, K11.14
/Outputs/NO_3: J12.1, K12.14
/Outputs/NO_4: J13.1, K13.14
/Outputs/NO_5: J14.1, K14.14
/Outputs/Relay_1: K10.A2, R1.2, U2.18 (O1)
/Outputs/Relay_2: K11.A2, R2.2, U2.17 (O2)
/Outputs/Relay_3: K12.A2, R3.2, U2.16 (O3)
/Outputs/Relay_4: K13.A2, R5.2, U2.15 (O4)
/Outputs/Relay_5: K14.A2, R4.2, U2.14 (O5)
GND: R10.2, R11.2, R12.2, R13.2, R14.2, U2.9 (GND); also elsewhere on the board
MCU_RELAY_1: R14.1, U2.1 (I1); also elsewhere on the board
MCU_RELAY_2: R13.1, U2.2 (I2); also elsewhere on the board
MCU_RELAY_3: R12.1, U2.3 (I3); also elsewhere on the board
MCU_RELAY_4: R11.1, U2.4 (I4); also elsewhere on the board
MCU_RELAY_5: R10.1, U2.5 (I5); also elsewhere on the board
unnamed: D1.1 (K), R1.1
unnamed: D2.1 (K), R2.1
unnamed: D3.1 (K), R3.1
unnamed: D4.1 (K), R5.1
unnamed: D5.1 (K), R4.1
unnamed: F1.1, K10.11
unnamed: F2.1, K11.11
unnamed: F3.1, K12.11
unnamed: F4.1, K13.11
unnamed: F5.1, K14.11

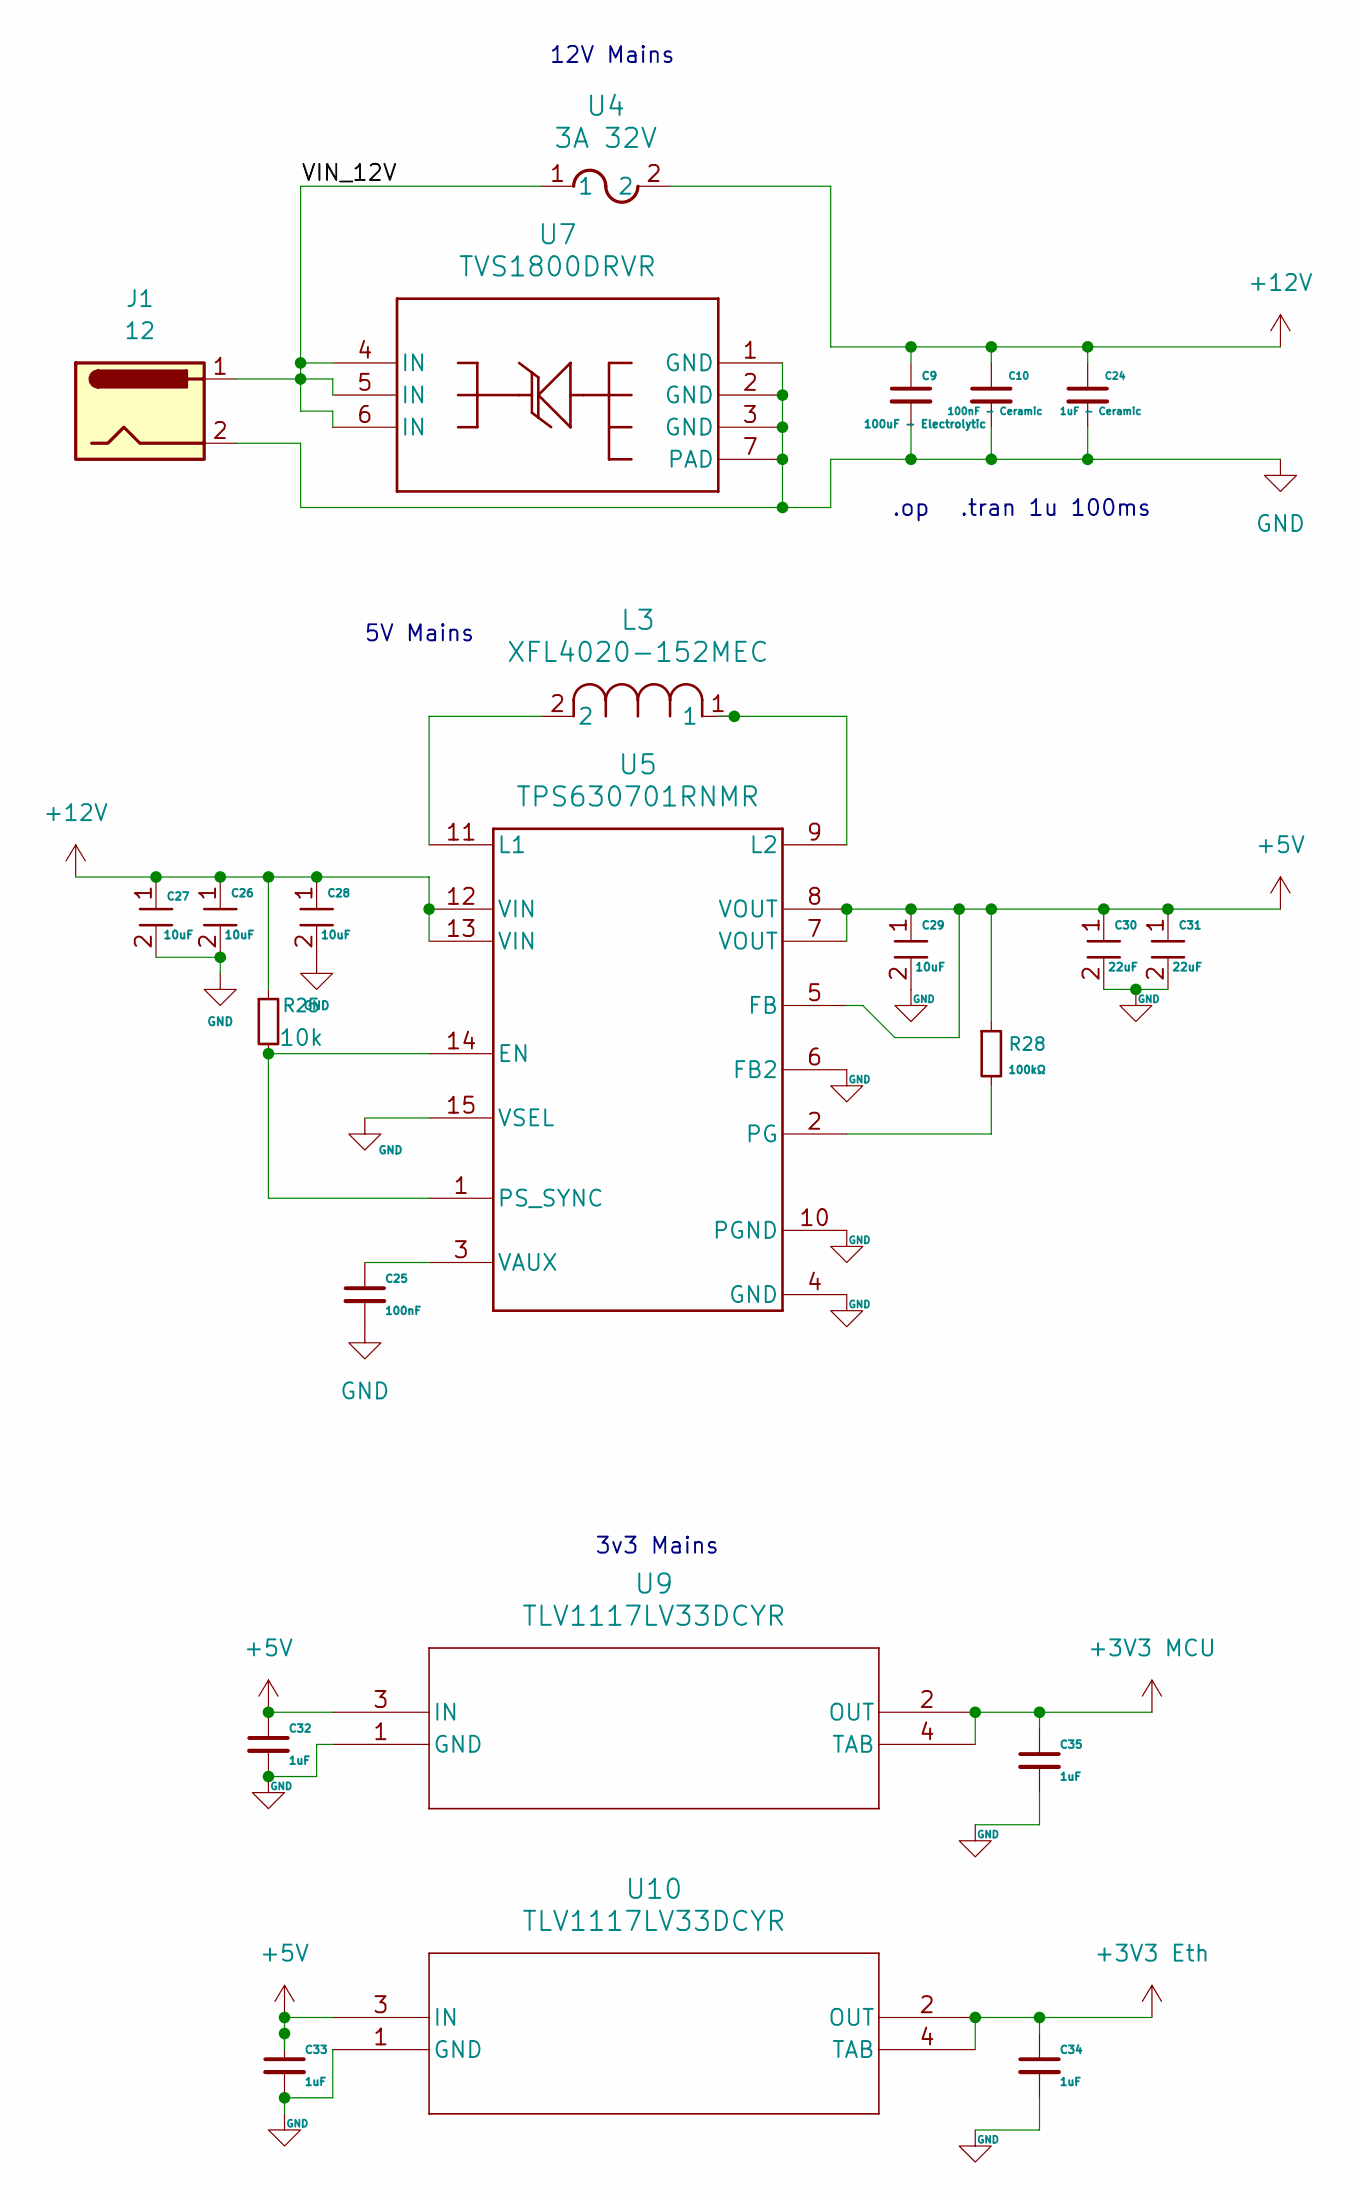
[picture p5: schematic Power.kicad_sch]

Parts:
C9: 100uF - Electrolytic; C_Elec_6.3x7.7
C10: 100nF - Ceramic; C_0603_1608Metric
C24: 1uF - Ceramic; C_0805_2012Metric
C25: 100nF; C_0201_0603Metric
C26, C27: 10uF; C_0805_2012Metric
C28, C29: 10uF; C_0603_1608Metric
C30, C31: 22uF; C_0805_2012Metric
C32, C33, C34, C35: 1uF; C_0805_2012Metric
J1: 12; BarrelJack_CUI_PJ-102AH_Horizontal
L3: XFL4020-152MEC; IND_XFL4020_COC-M
R25: 10k; R_0603_1608Metric
R28: 100kΩ; R_0603_1608Metric
U4: 3A 32V; Fuse_1206_3216Metric
U5: TPS630701RNMR; RNM0015A
U7: TVS1800DRVR; DRV0006A_NV
U9, U10: TLV1117LV33DCYR; TLV1117-33IDCYR

Connections:
3V3 MCU: C35.1, U9.2 (OUT), U9.4 (TAB); also elsewhere on the board
+3V3 Eth: C34.1, U10.2 (OUT), U10.4 (TAB); also elsewhere on the board
+5V: C29.1, C30.1, C31.1, C32.1, C33.1, R28.1, U5.5 (FB), U5.7 (VOUT), U5.8 (VOUT), U9.3 (IN), U10.3 (IN); also elsewhere on the board
+12V: C9.1, C10.1, C24.1, C26.1, C27.1, C28.1, R25.1, U4.2, U5.12 (VIN), U5.13 (VIN); also elsewhere on the board
/Power/VIN_12V: J1.1, U4.1, U7.4 (IN), U7.5 (IN), U7.6 (IN)
GND: C9.2, C10.2, C24.2, C25.2, C26.2, C27.2, C28.2, C29.2, C30.2, C31.2, C32.2, C33.2, C34.2, C35.2, J1.2, U5.4 (GND), U5.6 (FB2), U5.10 (PGND), U5.15 (VSEL), U7.1 (GND), U7.2 (GND), U7.3 (GND), U7.7 (PAD), U9.1 (GND), U10.1 (GND); also elsewhere on the board
unnamed: R25.2, U5.1 (PS_SYNC), U5.14 (EN)
unnamed: L3.2, U5.11 (L1)
unnamed: L3.1, U5.9 (L2)
unnamed: R28.2, U5.2 (PG)
unnamed: C25.1, U5.3 (VAUX)

Notes on the sheet:
3v3 Mains
12V Mains
5V Mains
.tran 1u 100ms
.op

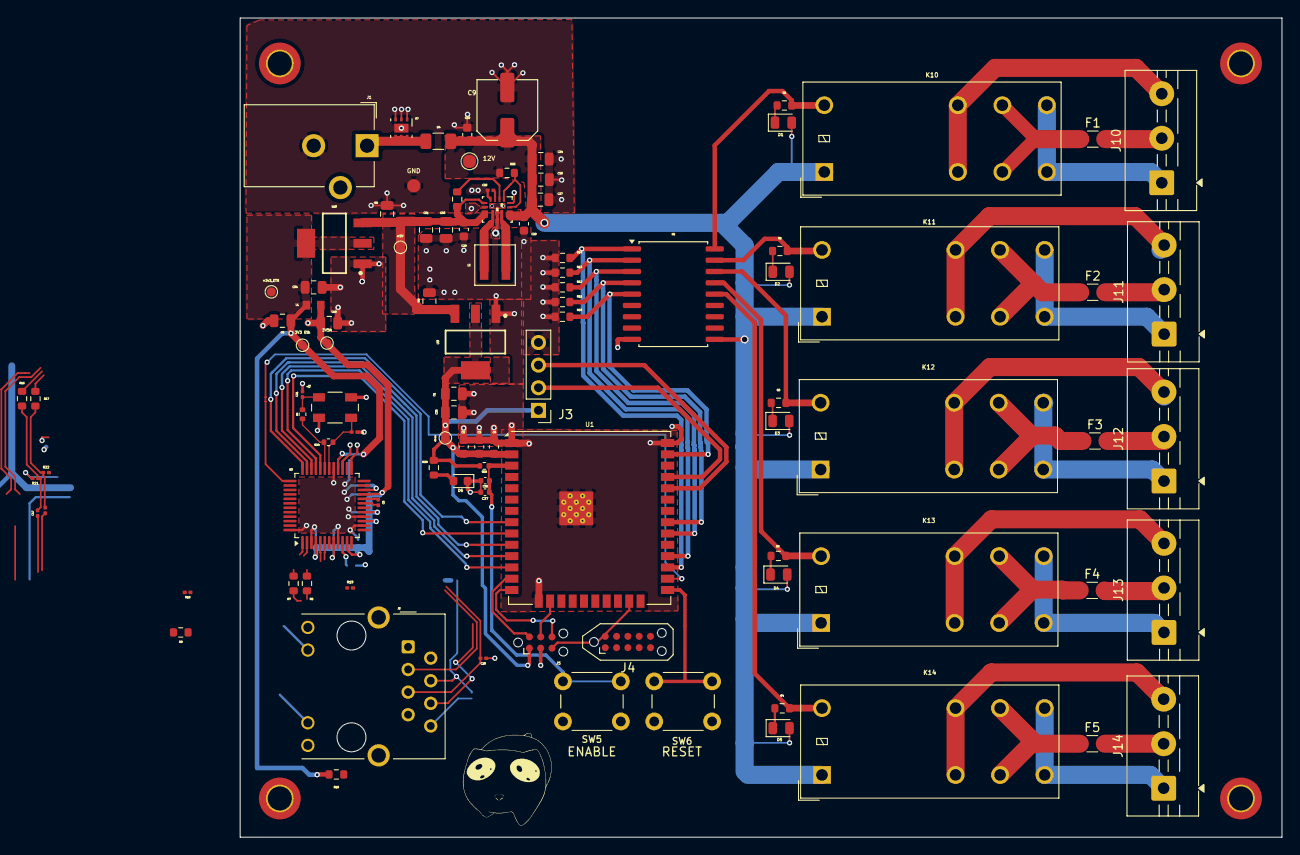
[picture p6: board 48VERelay.kicad_pcb from above]

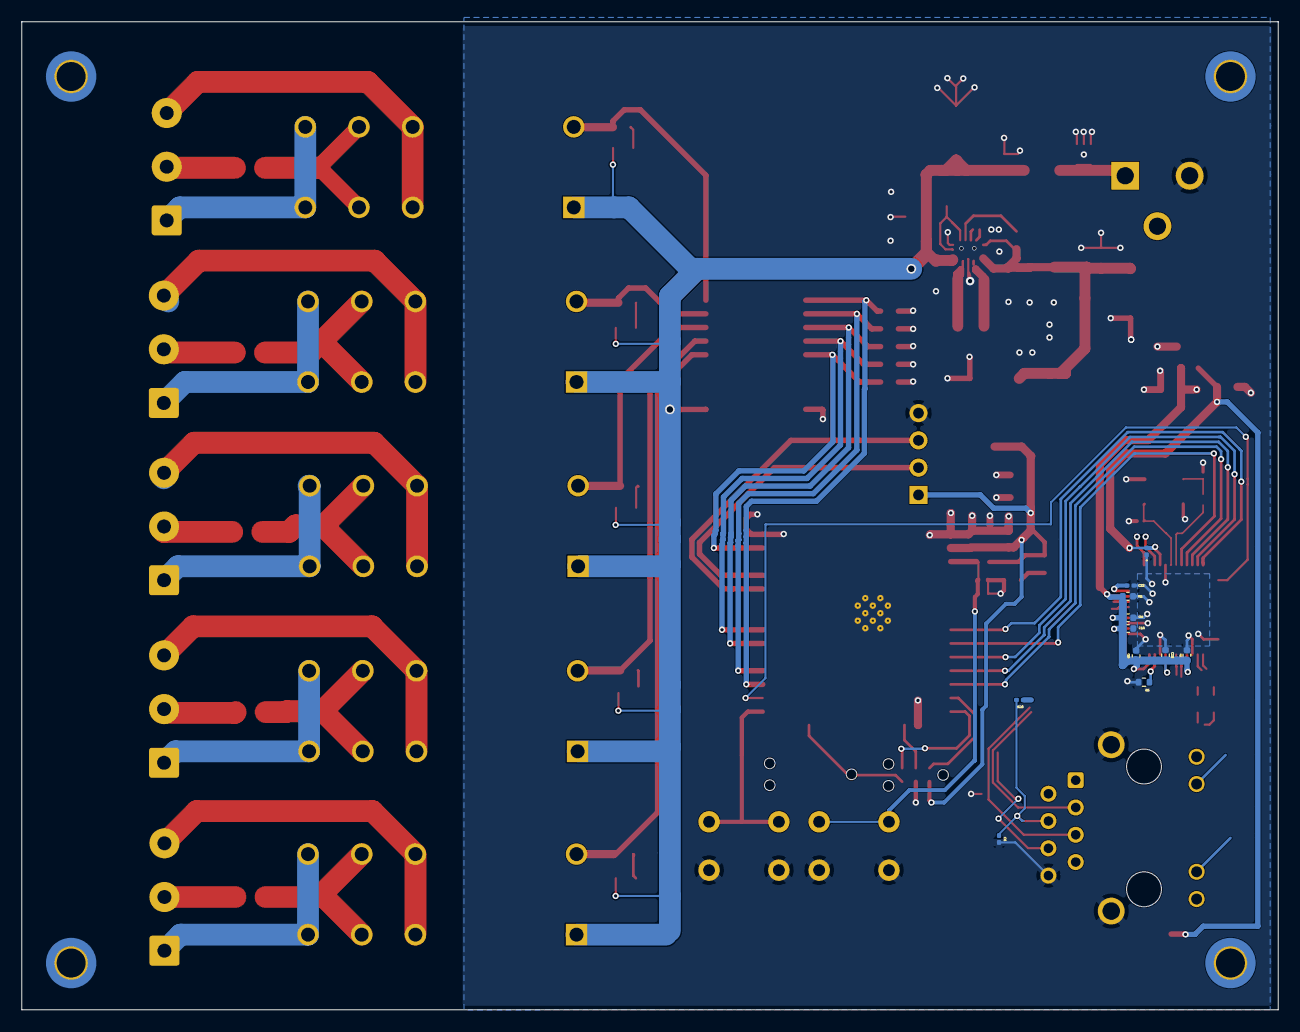
[picture p7: board 48VERelay.kicad_pcb from below]

Board: 4 copper layers, 117.0 x 92.0 mm, 111 parts (11 on the bottom side), 84 nets.

Other parts of the board:
3V3 Eth, 3V3 MCU, 3V3A: TestPoint_Pad_D1.0mm
12V: TestPoint_Pad_D1.5mm
+3v3_ETH, +5V: TestPoint_Pad_D1.0mm
GND: (no value)
J4: TC2050; Tag-Connect_TC2050-IDC-NL_2x05_P1.27mm_Vertical

Their connections:
3V3 MCU: 3V3 MCU.1; also elsewhere on the board
+3V3 Eth: 3V3 Eth.1, +3v3_ETH.1; also elsewhere on the board
+3V3A: 3V3A.1; also elsewhere on the board
+5V: +5V.1; also elsewhere on the board
+12V: 12V.1; also elsewhere on the board
GND: GND.1; also elsewhere on the board
