StickOnAStick/48VRelay_essential/(commit log)

2026-06-17 begin pcb design
    [48VERelay.kicad_pcb, 48VERelay.kicad_sch, Connectors.kicad_sch, MCU.kicad_sch, Outputs.kicad_sch, Power.kicad_sch]
2026-06-22 Begin PCB layout
    [48VERelay.kicad_pcb, MCU.kicad_sch, Outputs.kicad_sch, Power.kicad_sch]
2026-06-27 5v5 Buck Added
    [48VERelay.kicad_pcb, 48VERelay.kicad_sch, Connectors.kicad_sch, MCU.kicad_sch, Outputs.kicad_sch, Power.kicad_sch]
2026-06-29 Fix 12V->5V add power plane
    [48VERelay.kicad_pcb, Power.kicad_sch]
2026-07-04 update layout
    [48VERelay.kicad_pcb, Power.kicad_sch]
2026-07-12 Route ethernet
    [48VERelay.kicad_pcb, 48VERelay.kicad_sch, Connectors.kicad_sch, MCU.kicad_sch, Outputs.kicad_sch, Power.kicad_sch]
2026-07-12 Update tx / rx nets
    [MCU.kicad_sch]
2026-07-12 update tx/rx eth routing
    [48VERelay.kicad_pcb, Connectors.kicad_sch, MCU.kicad_sch]
2026-07-13 JTAG left
    [48VERelay.kicad_pcb, Connectors.kicad_sch, MCU.kicad_sch, Outputs.kicad_sch]
2026-07-14 update relay traces
    [48VERelay.kicad_pcb]
2026-07-20 update txrx routing length
    [Connectors.kicad_sch, MCU.kicad_sch, Power.kicad_sch]
2026-07-20 update schematic footprint and rule set
    [48VERelay.kicad_pcb]
2026-07-21 wired uart and jtag
    [48VERelay-B_Cu.gbr, 48VERelay-B_Mask.gbr, 48VERelay-B_Paste.gbr, 48VERelay-B_Silkscreen.gbr, 48VERelay-Edge_Cuts.gbr, 48VERelay-F_Cu.gbr, 48VERelay-F_Mask.gbr, 48VERelay-F_Paste.gbr]
2026-07-22 update layout to include images
    [48VERelay.kicad_pcb]
2026-07-26 update bom
    [48VRelay_Approved_Vendor_List.xlsx, 48VRelay_Approved_Vendor_List_RevD.xlsx, 48VRelay_Manufacturing_BOM.xlsx, 48VRelay_Manufacturing_BOM_RevC.xlsx, 48VRelay_Manufacturing_BOM_RevD (1).xlsx, 48VRelay_Manufacturing_BOM_RevD.xlsx, 48VRelay_Sourced_BOM_AVL.xlsx]
2026-08-09 Fixed jtag, fixed diff pair routing, removed fuses
    [48VERelay-B_Courtyard.gbr, 48VERelay-B_Cu.gbr, 48VERelay-B_Fab.gbr, 48VERelay-B_Mask.gbr, 48VERelay-B_Paste.gbr, 48VERelay-B_Silkscreen.gbr, 48VERelay-Edge_Cuts.gbr, 48VERelay-F_Courtyard.gbr]
